jof/patternflood/hardware/laser/MANIFEST.md

# Laser-cut parts

Generated by `hardware/cad/tools/export_dxf.py` from the Onshape enclosure studio —
do not edit by hand; change the model and re-run.

- **40 parts, 28 files.** DXF R12, millimetres, one closed cut path per
  outline/hole on layer `CUT`. Every part is a through-cut of one sheet.
- Cut with **#thickness = 3.18 mm** and **#kerf = 0.15 mm** baked in: tabs and
  holes are already compensated. Both come from the test cuts; re-measure for new stock,
  set them, then re-run this export.
- **Drawn as seen from outside the box.** Cut each part as drawn and the face that
  was up on the bed is its outside face — the bezel's front, the walls' outer faces.
- **To cut the whole box, use [`sheets/`](sheets/README.md)**: every part nested on
  12 × 24" sheets (`nest_sheets.py`).
- **Paper light diffusers** for the knob LEDs: [`diffusers/`](diffusers/README.md) (`diffusers.py`).
- **Cut [`test-cuts/`](test-cuts/README.md) first** — kerf, nut pockets, hole sizes, the
  panel jig and the board templates, all on one 12 × 12" sheet. Then
  [`test-cuts/part-2/`](test-cuts/part-2/README.md): the laminated knob stack, the Pi 5,
  the buttons, the supply's screws and the etch.
- Material: 3 mm Baltic birch, B/BB (enclosure-lasercut.md §13). Everything fits
  across the xTool P2's 305 mm axis.

| File | Qty | Size (mm) | Parts |
|---|---|---|---|
| `bezel-outer.dxf` | 1 | 293.0 × 373.0 | Bezel outer |
| `bezel-inner.dxf` | 1 | 286.6 × 366.6 | Bezel inner |
| `back-cover.dxf` | 1 | 286.0 × 366.0 | Back cover |
| `back-cover-doubler.dxf` | 1 | 285.6 × 309.6 | Back cover doubler |
| `electronics-tray-front-sheet.dxf` | 1 | 279.3 × 94.0 | Electronics tray, front sheet |
| `electronics-tray-rear-sheet-board-nuts.dxf` | 1 | 279.3 × 94.0 | Electronics tray, rear sheet (board nuts) |
| `panel-brace-middle.dxf` | 2 | 293.0 × 80.2 | Panel brace middle; Panel brace middle, rear sheet |
| `panel-brace-middle-middle-sheet-tray-nuts.dxf` | 1 | 293.0 × 80.2 | Panel brace middle, middle sheet (tray nuts) |
| `wall-left.dxf` | 1 | 60.7 × 373.0 | Wall left |
| `wall-right-iec.dxf` | 1 | 60.7 × 373.0 | Wall right (IEC) |
| `wall-bottom.dxf` | 1 | 293.0 × 60.7 | Wall bottom |
| `wall-top.dxf` | 1 | 293.0 × 60.7 | Wall top |
| `wall-left-doubler.dxf` | 1 | 41.1 × 365.6 | Wall left doubler |
| `wall-right-doubler-iec.dxf` | 1 | 41.1 × 365.6 | Wall right doubler (IEC) |
| `stiffener-shelf.dxf` | 1 | 293.0 × 44.8 | Stiffener shelf |
| `panel-brace-upper.dxf` | 1 | 293.0 × 40.2 | Panel brace upper |
| `panel-brace-lower.dxf` | 1 | 293.0 × 40.2 | Panel brace lower |
| `wall-bottom-doubler-psu.dxf` | 1 | 279.3 × 41.1 | Wall bottom doubler (PSU) |
| `wall-top-doubler.dxf` | 1 | 279.3 × 41.1 | Wall top doubler |
| `rail-c-tenoned.dxf` | 2 | 293.0 × 18.2 | Rail C lower (tenoned); Rail C upper (tenoned) |
| `rail-a-screw-clearance.dxf` | 2 | 286.6 × 18.0 | Rail A lower (screw clearance); Rail A upper (screw clearance) |
| `rail-b-lower-hex-pocket.dxf` | 1 | 286.6 × 18.0 | Rail B lower (hex pocket) |
| `rail-b-upper-hex-pocket.dxf` | 1 | 286.6 × 18.0 | Rail B upper (hex pocket) |
| `knob-rib-1.dxf` | 1 | 44.0 × 85.7 | Knob rib 1 |
| `knob-rib-2.dxf` | 1 | 44.0 × 85.7 | Knob rib 2 |
| `spacer-ring-tray-to-brace.dxf` | 4 | 8.0 × 8.0 | Spacer ring — tray to brace |
| `spacer-ring-colorlight.dxf` | 4 | 7.0 × 7.0 | Spacer ring — Colorlight 1; Spacer ring — Colorlight 2; Spacer ring — Colorlight 3; Spacer ring — Colorlight 4 |
| `spacer-ring-pi-m2.5.dxf` | 4 | 7.0 × 7.0 | Spacer ring — Pi 1; Spacer ring — Pi 2; Spacer ring — Pi 3; Spacer ring — Pi 4 |

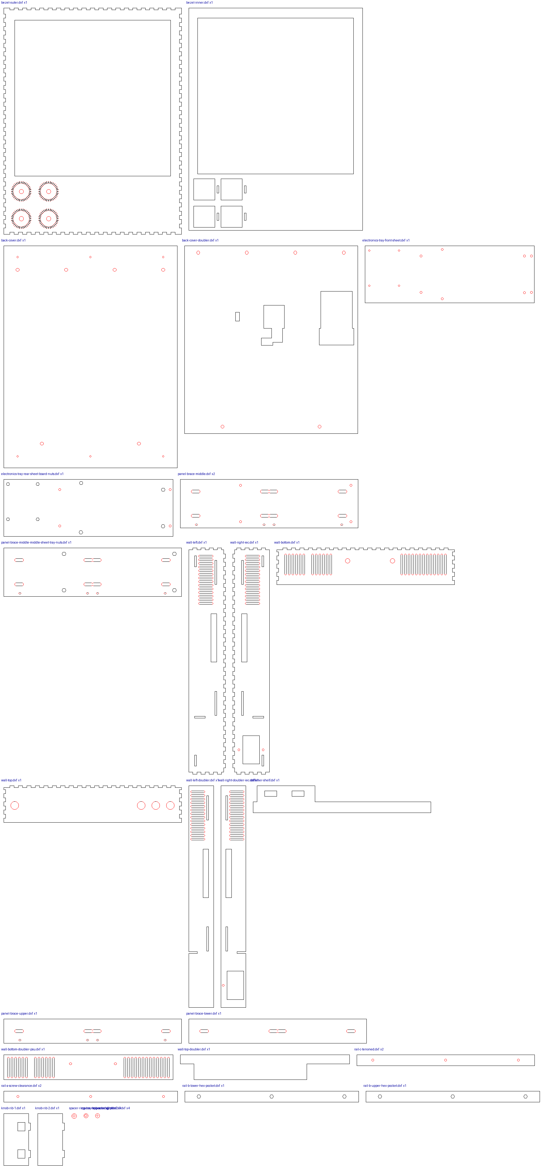
[picture p20: hardware/laser/preview.png]
All parts
