jof/patternflood/docs/desktop/img/box-p2.5.png

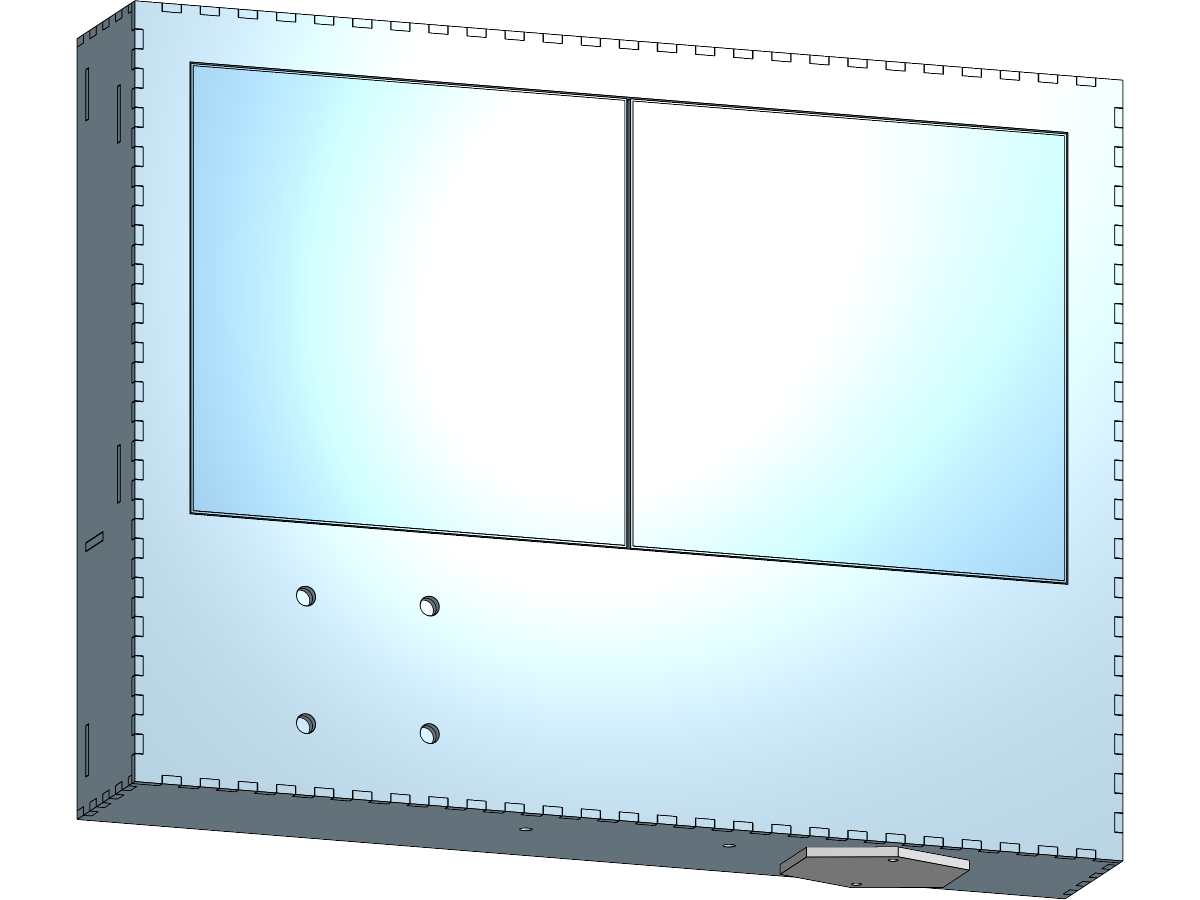
docs/desktop/img/box-p2.5.png
