jof/patternflood/docs/desktop/img/box-p2.png

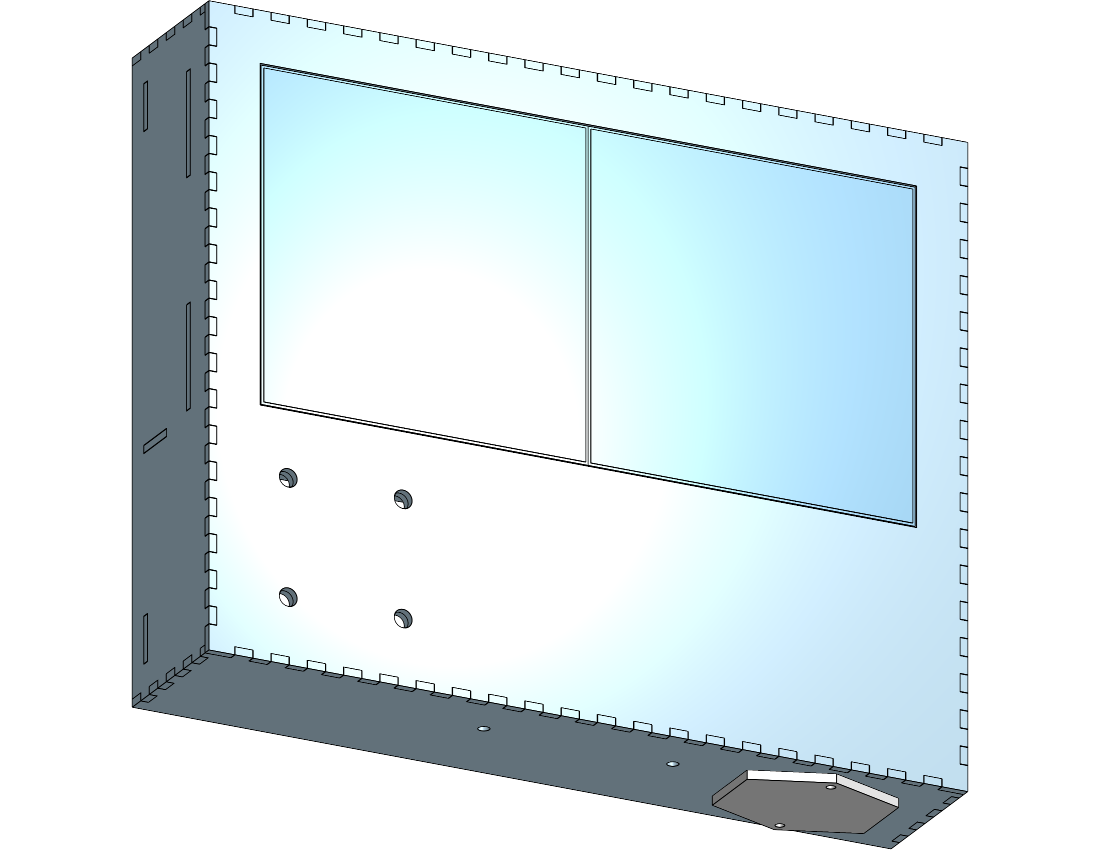
docs/desktop/img/box-p2.png
