jof/patternflood/docs/desktop/img/p2-dims-sheet.png

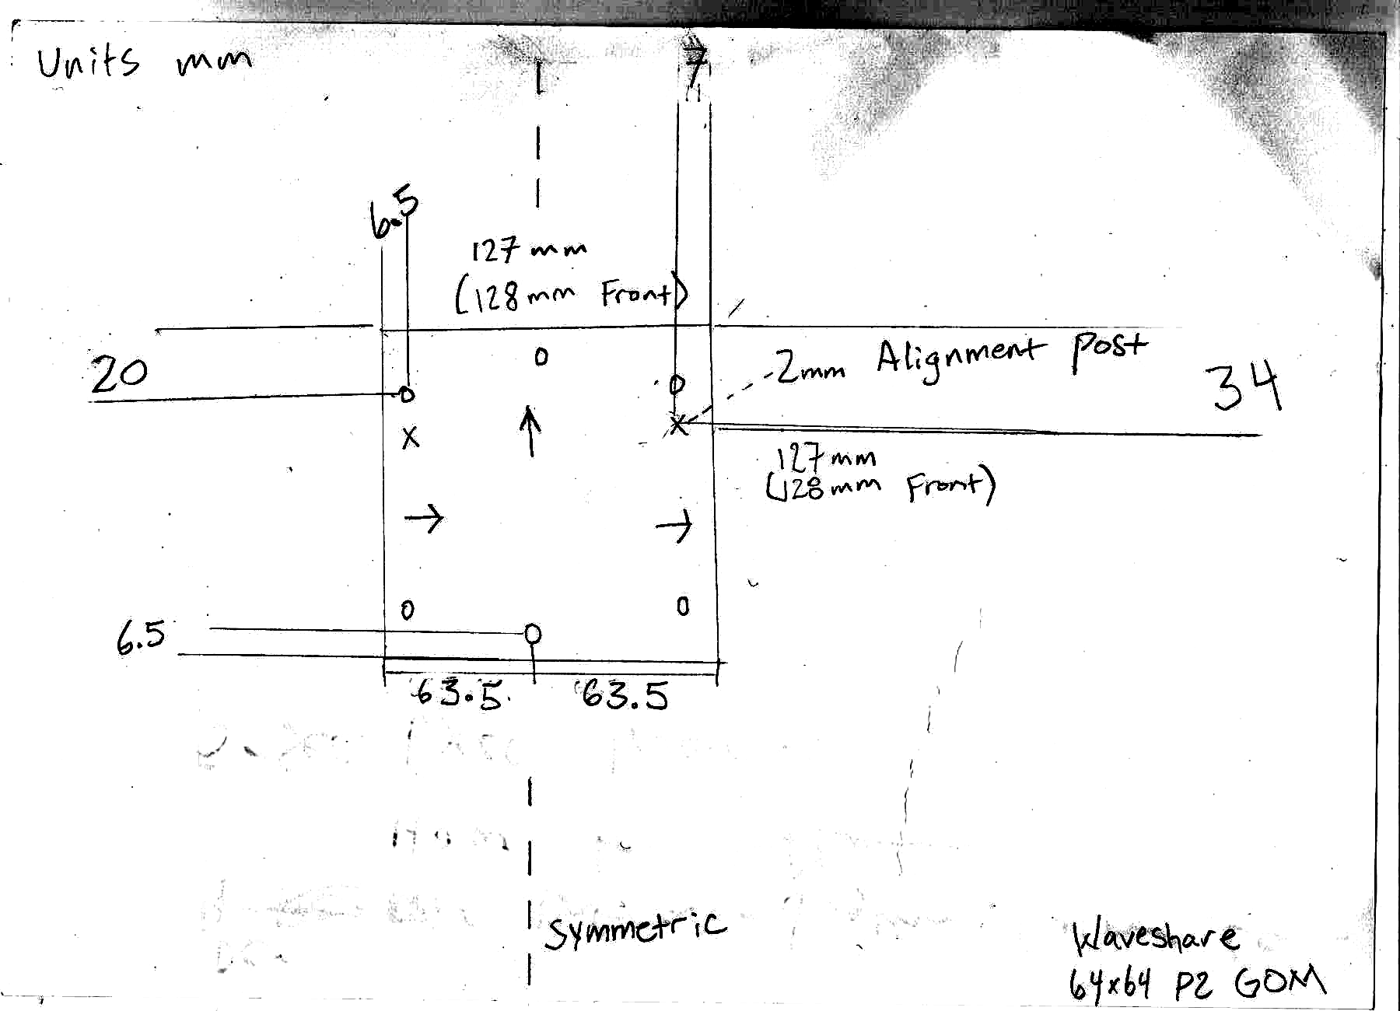
docs/desktop/img/p2-dims-sheet.png
