jof/patternflood/docs/desktop/img/p2-rear-scan-600dpi.jpg

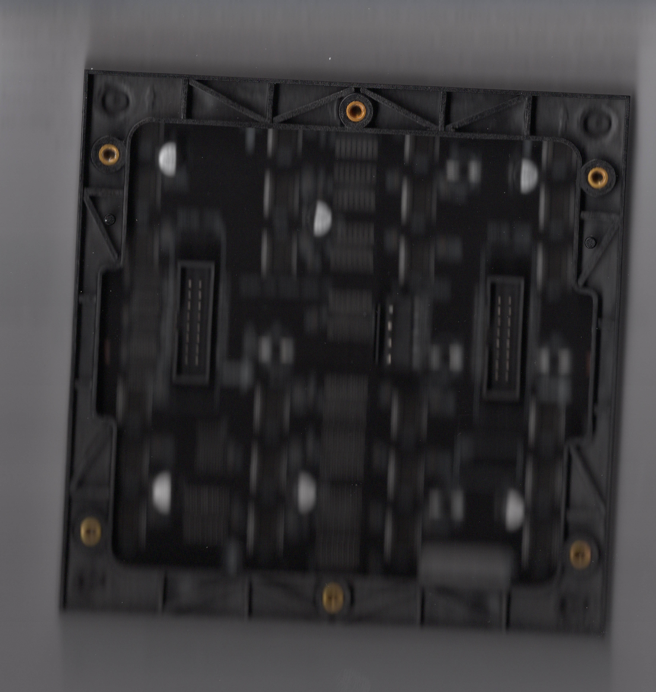
docs/desktop/img/p2-rear-scan-600dpi.jpg
