jof/patternflood/firmware/demos/pfd/demos/earth/day.png

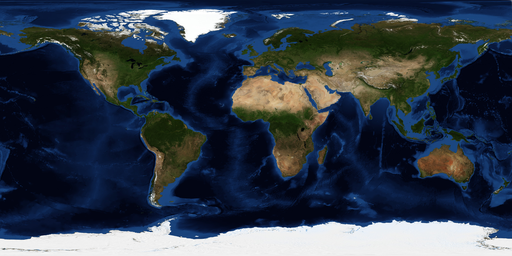
firmware/demos/pfd/demos/earth/day.png
