jof/patternflood/firmware/demos/pfd/demos/earth/night.png

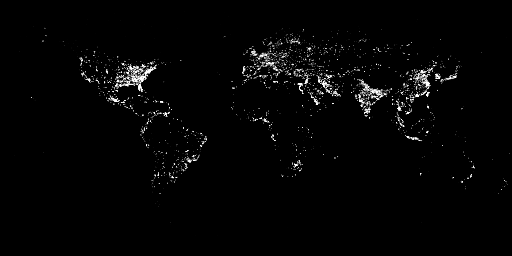
firmware/demos/pfd/demos/earth/night.png
