jof/patternflood/hardware/laser/art/back-cover.decal.png

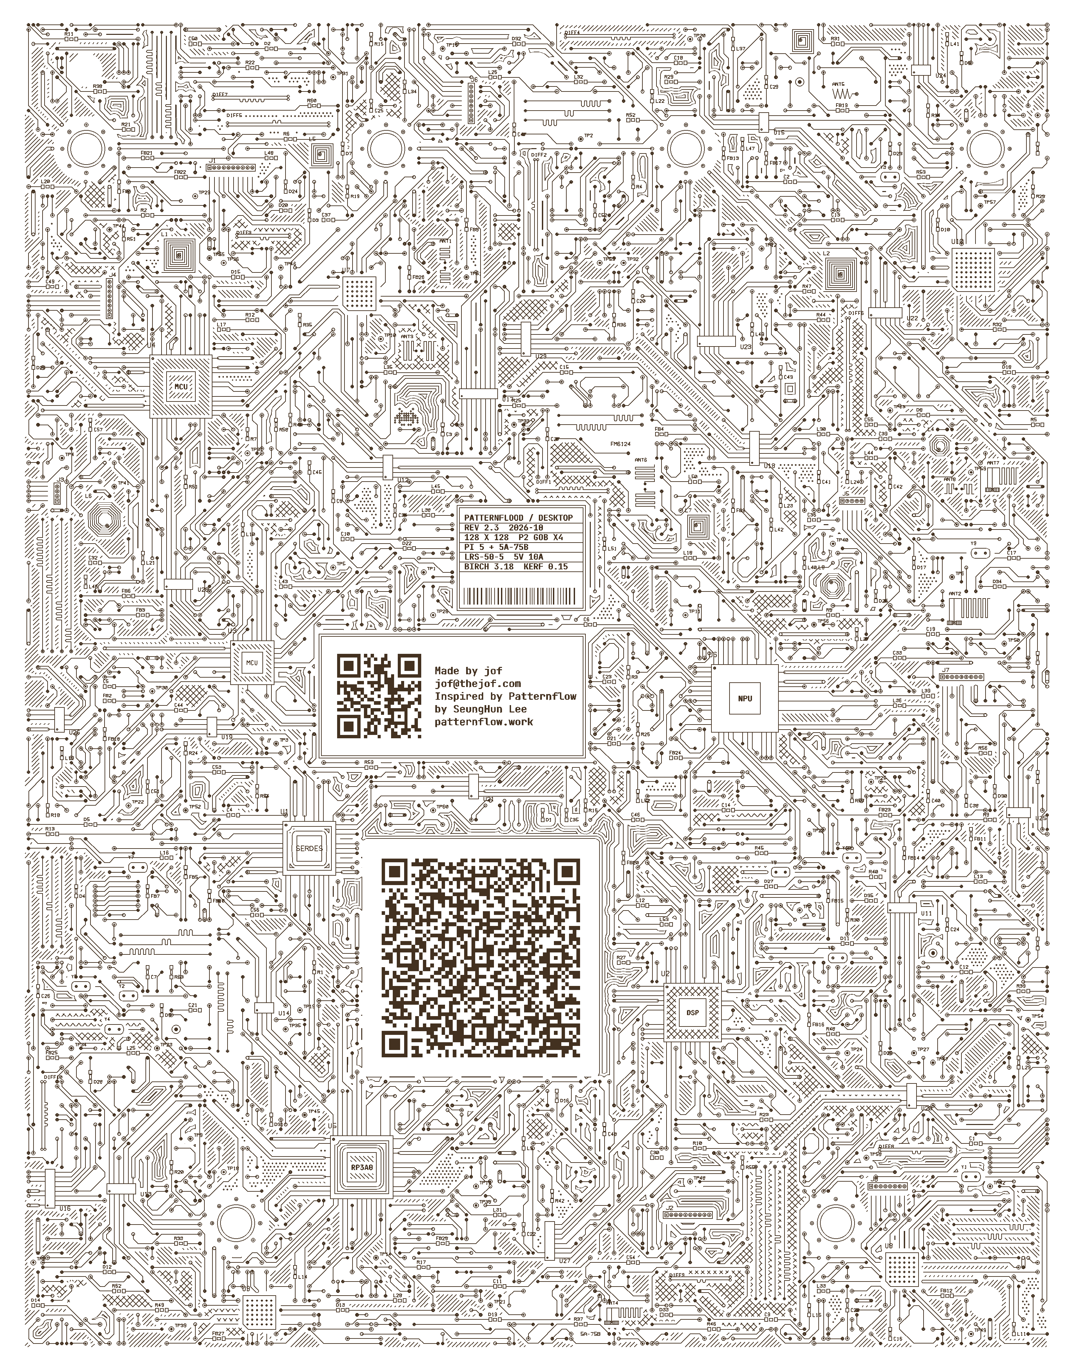
hardware/laser/art/back-cover.decal.png
