jof/patternflood/hardware/laser/art/bezel-outer.decal.png

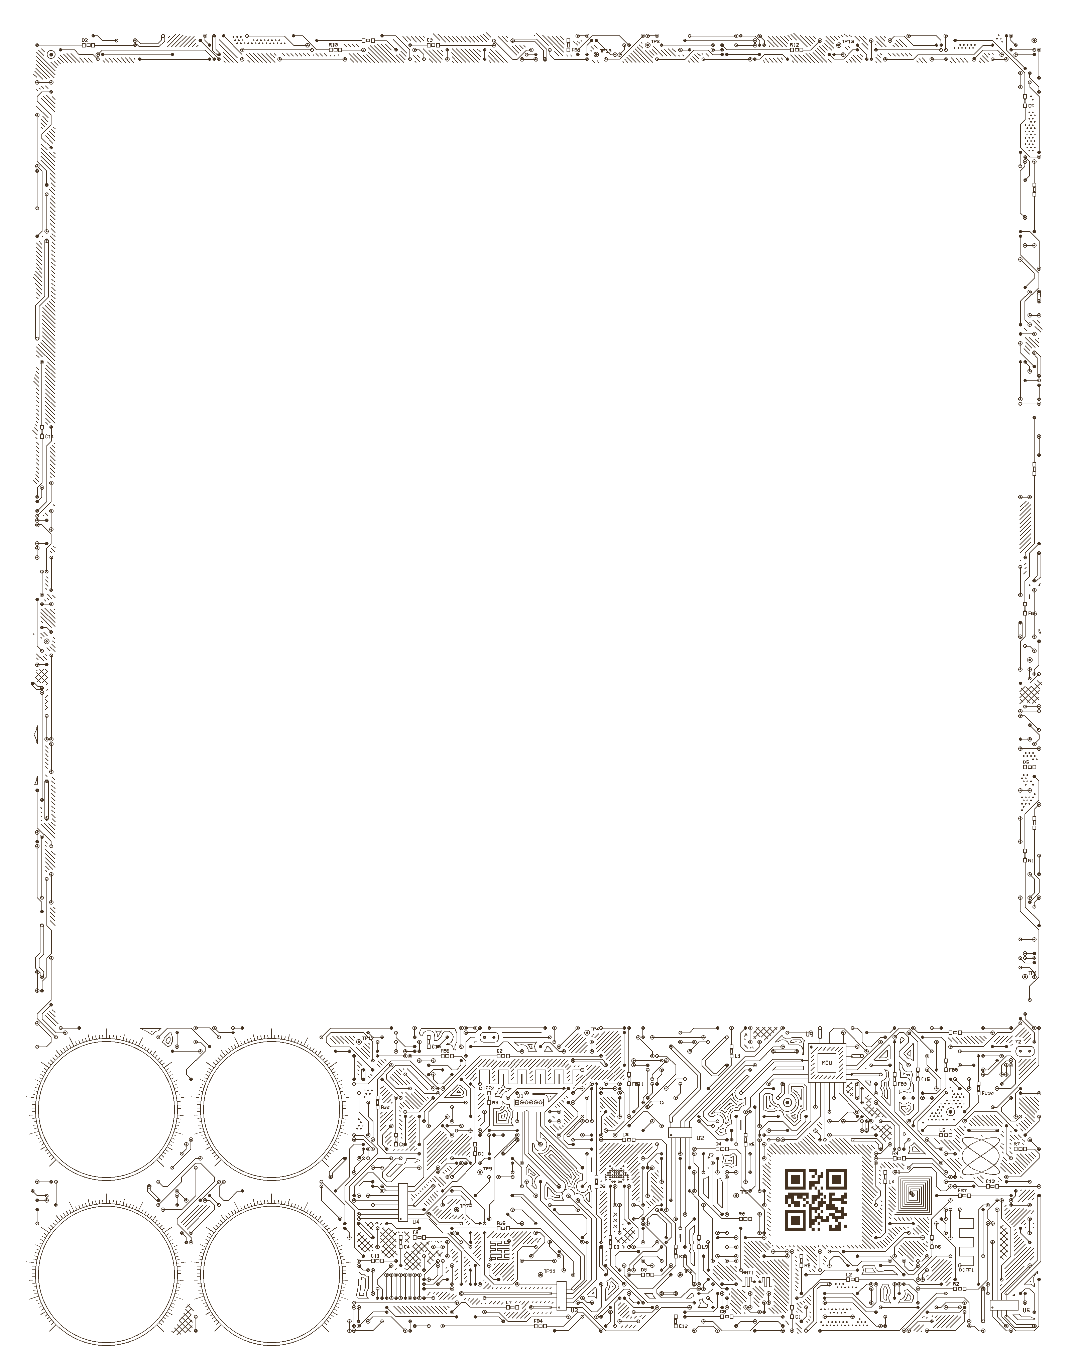
hardware/laser/art/bezel-outer.decal.png
