jof/patternflood/hardware/laser/art/preview.png

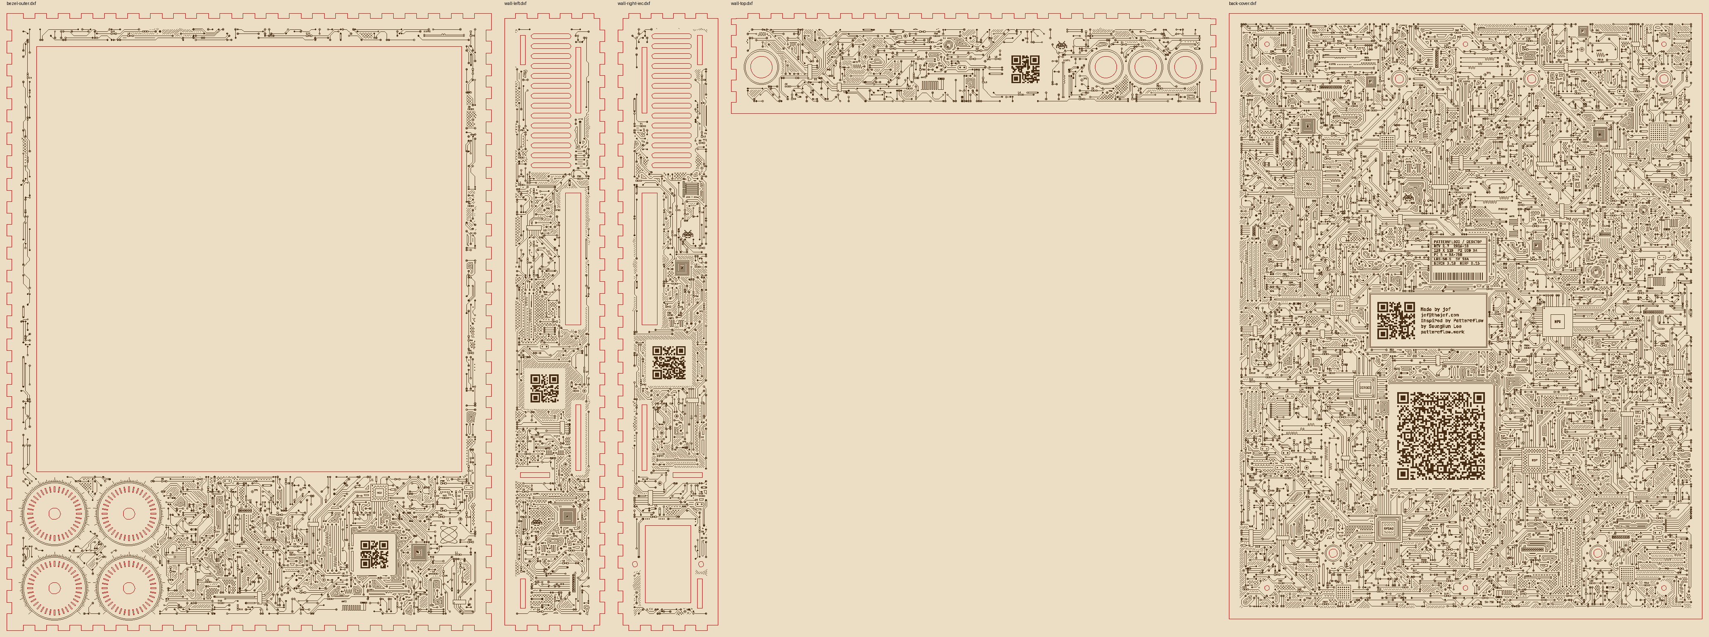
hardware/laser/art/preview.png
