jof/patternflood/hardware/laser/art/wall-left.decal.png

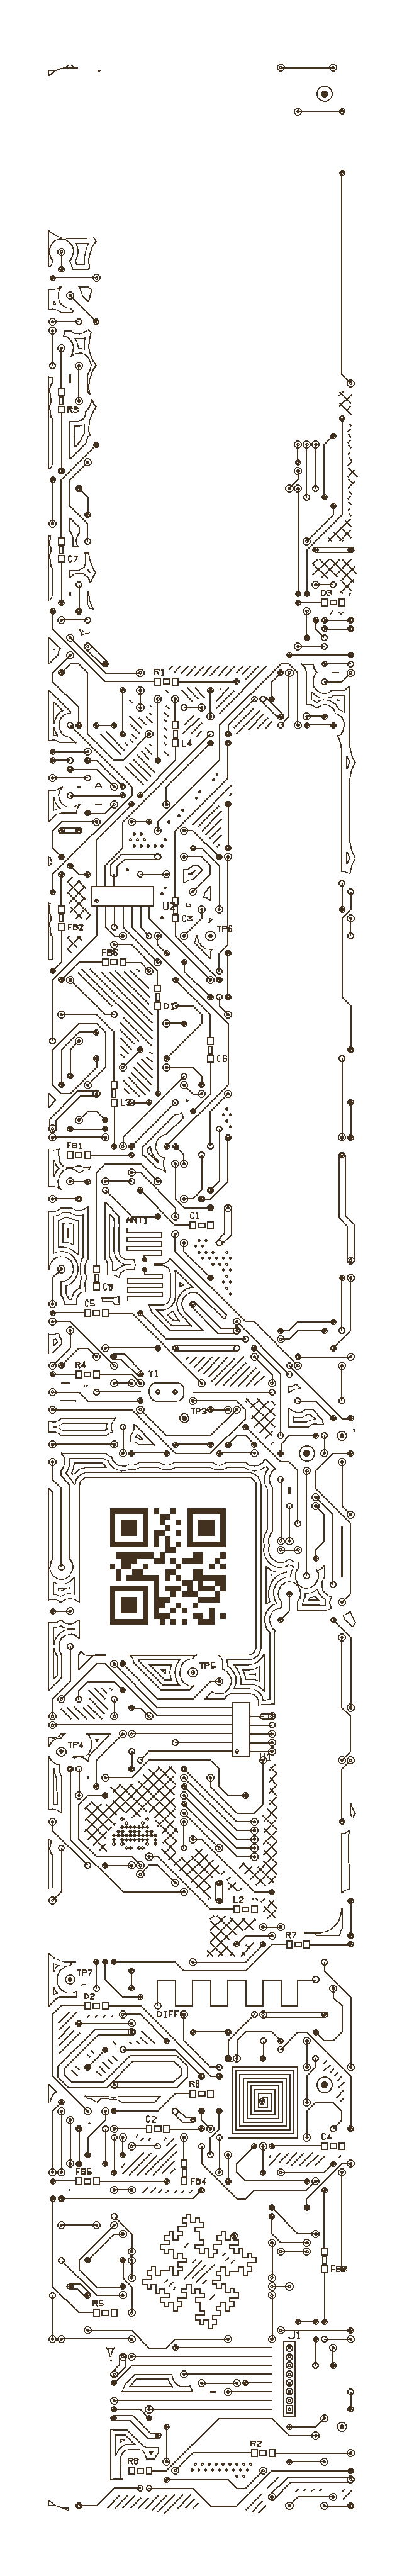
hardware/laser/art/wall-left.decal.png
