jof/patternflood/hardware/laser/art/wall-right-iec.decal.png

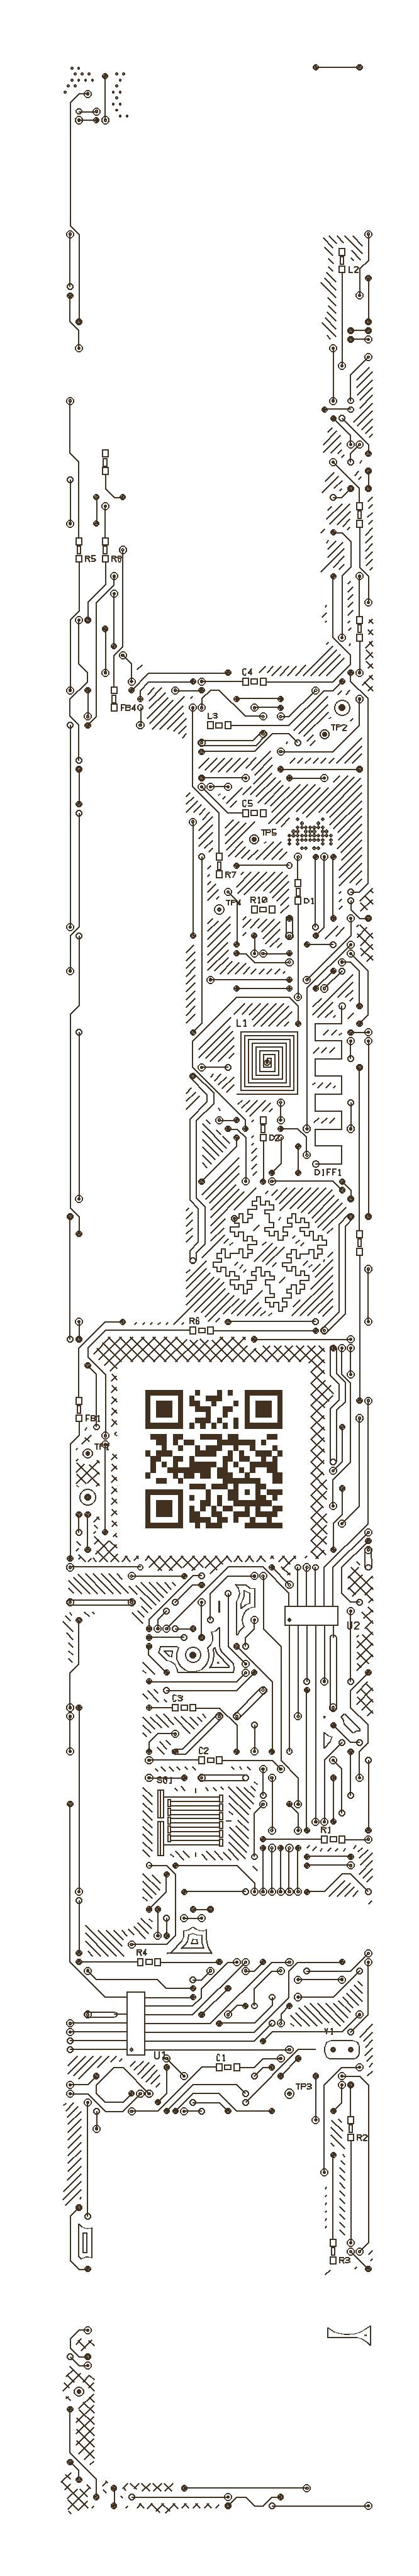
hardware/laser/art/wall-right-iec.decal.png
