jof/patternflood/hardware/laser/art/wall-top.decal.png

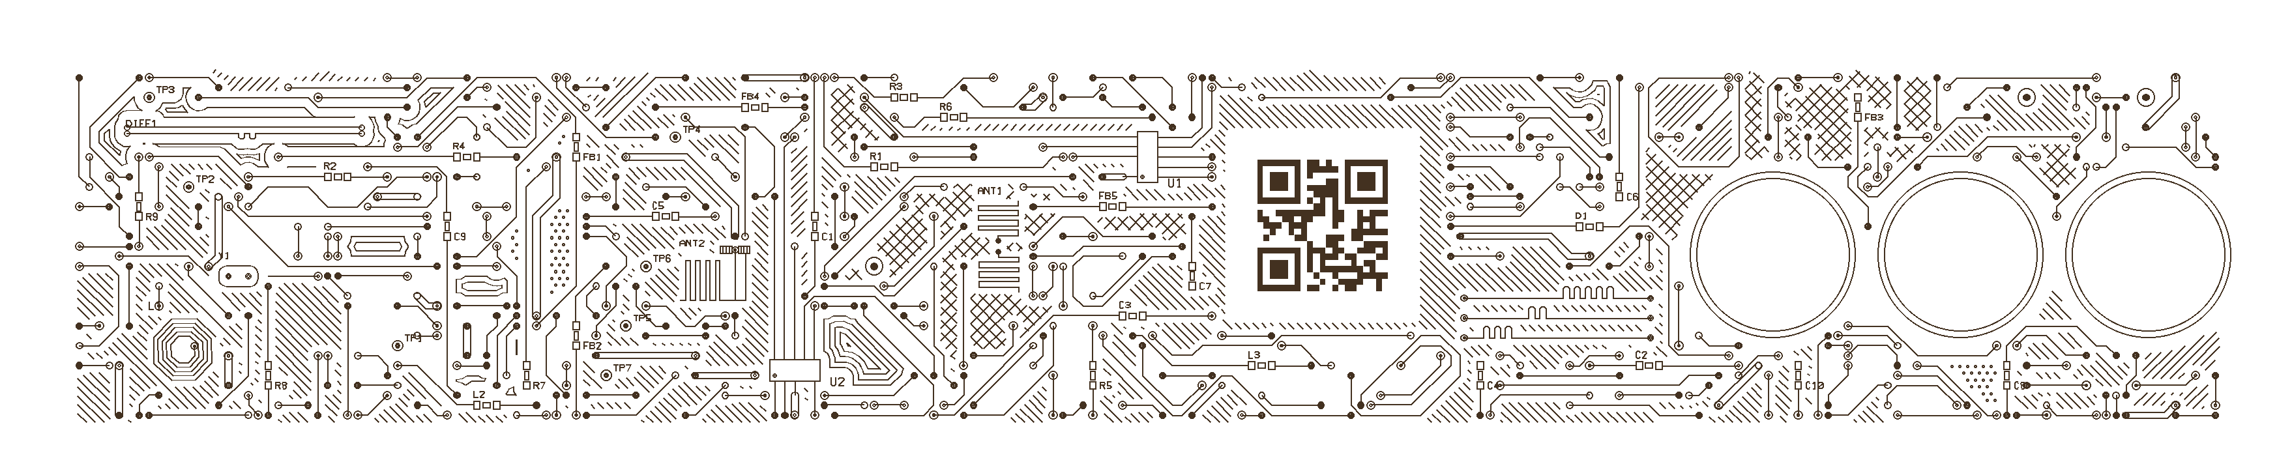
hardware/laser/art/wall-top.decal.png
