jof/patternflood/hardware/laser/sheets/recut-walls.png

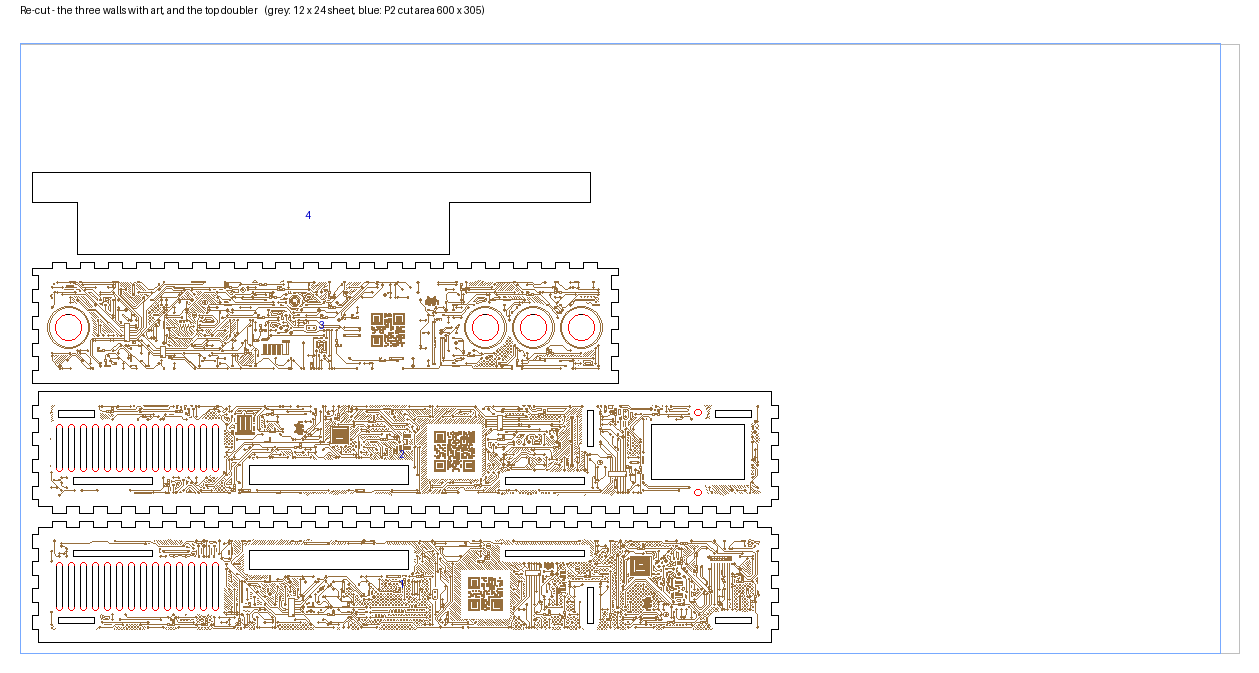
hardware/laser/sheets/recut-walls.png
