jof/patternflood/hardware/laser/art/back-cover.etch.dxf

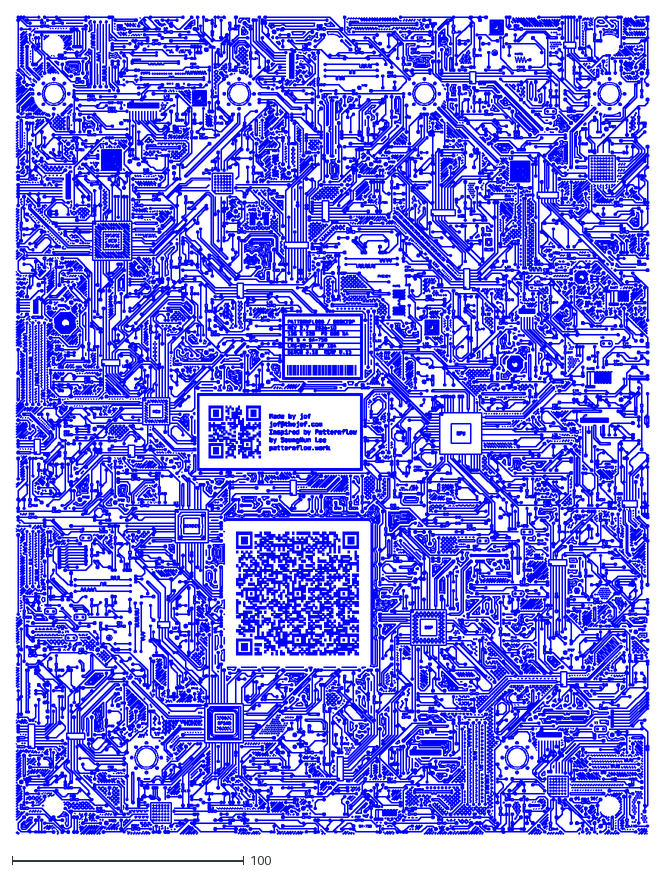
[picture p45: CAD file, 2026-10-26]
hardware/laser/art/back-cover.etch.dxf
273.2 x 353.2
