jof/patternflood/hardware/laser/diffusers/knob-diffusers.dxf

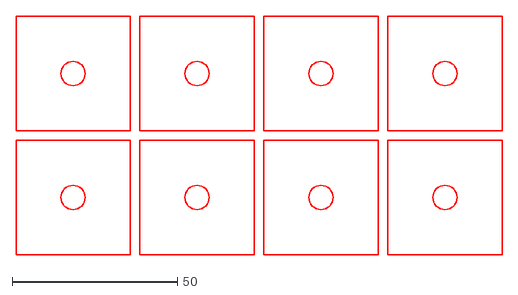
[picture p46: CAD file, 2026-10-25]
hardware/laser/diffusers/knob-diffusers.dxf
147.0 x 72.0
