jof/patternflood/hardware/laser/sheets/recut-walls.dxf

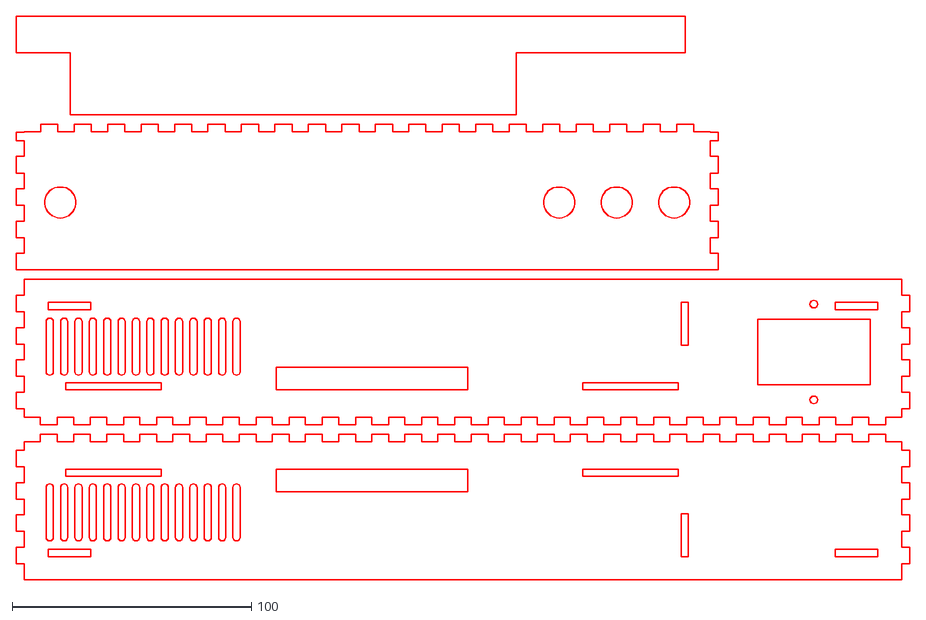
[picture p47: CAD file, 2026-10-26]
hardware/laser/sheets/recut-walls.dxf
373.0 x 235.3
