jof/patternflood/hardware/laser/test-cuts/all-test-cuts.dxf

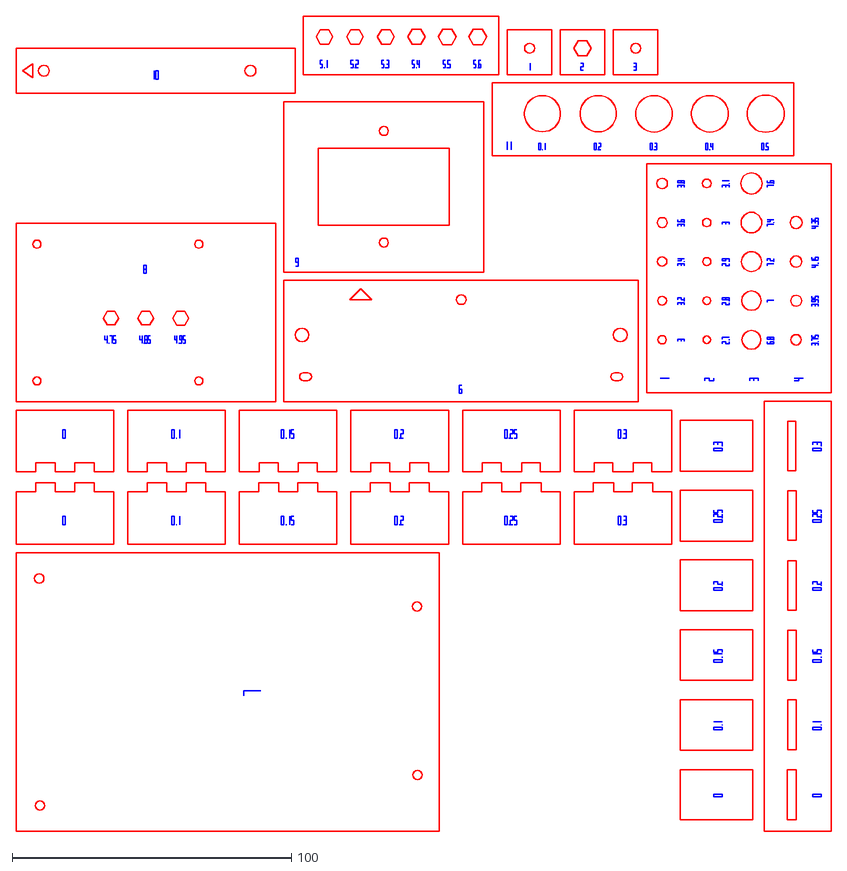
[picture p48: CAD file, 2026-10-26]
hardware/laser/test-cuts/all-test-cuts.dxf
292.0 x 292.0
