jof/patternflood/hardware/laser/test-cuts/part-2/17-pi-spacer-rings.dxf

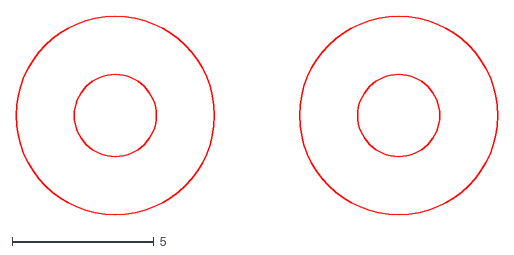
[picture p49: CAD file, 2026-10-30]
hardware/laser/test-cuts/part-2/17-pi-spacer-rings.dxf
17.0 x 7.00
