jof/patternflood/hardware/laser/test-cuts/since-rev-1/all-since-rev-1.dxf

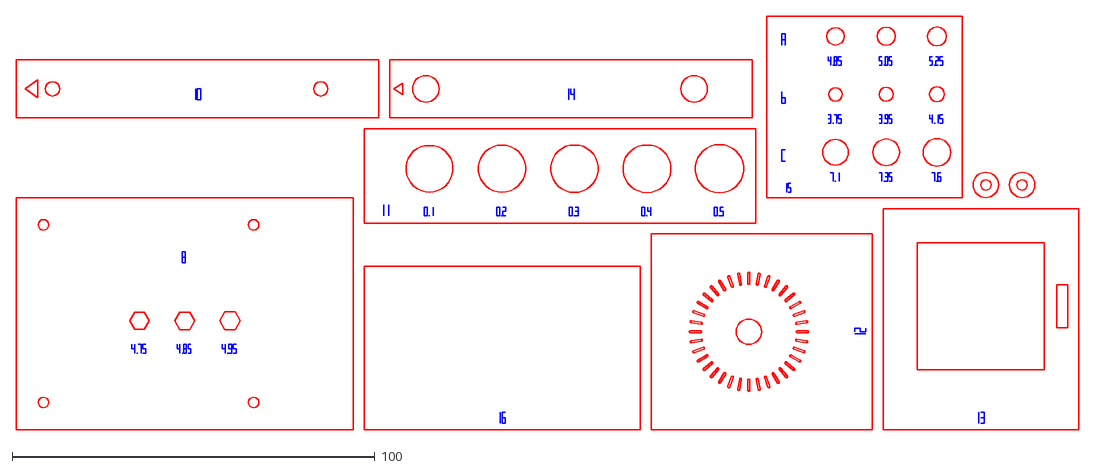
[picture p50: CAD file, 2026-10-26]
hardware/laser/test-cuts/since-rev-1/all-since-rev-1.dxf
293.1 x 114.0
