jof/patternflood/hardware/laser/wall-top.dxf

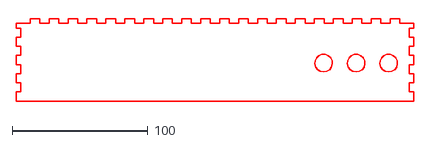
[picture p51: CAD file, 2026-10-26]
hardware/laser/wall-top.dxf
293.0 x 60.7
