jof/patternflood/hardware/laser/art/wall-top.etch.dxf

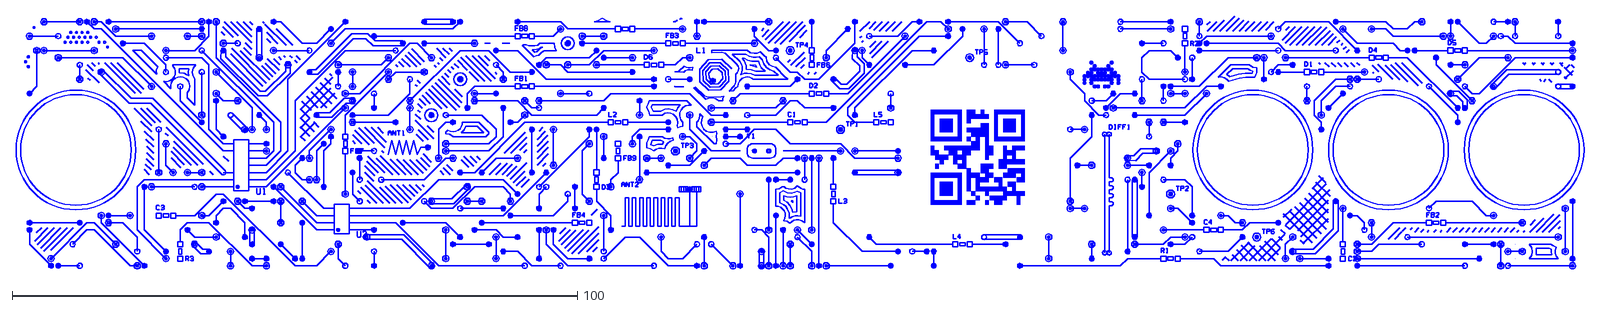
[picture p52: CAD file, 2026-10-26]
hardware/laser/art/wall-top.etch.dxf
277.5 x 44.7
