jof/patternflood/hardware/laser/diffusers/knob-diffuser.dxf

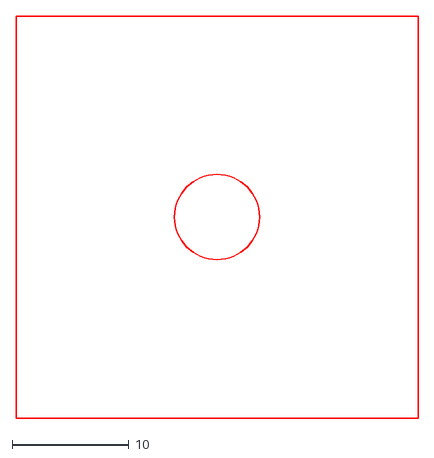
[picture p53: CAD file, 2026-10-25]
hardware/laser/diffusers/knob-diffuser.dxf
34.5 x 34.5
