jof/patternflood/hardware/laser/sheets/sheet-4.dxf

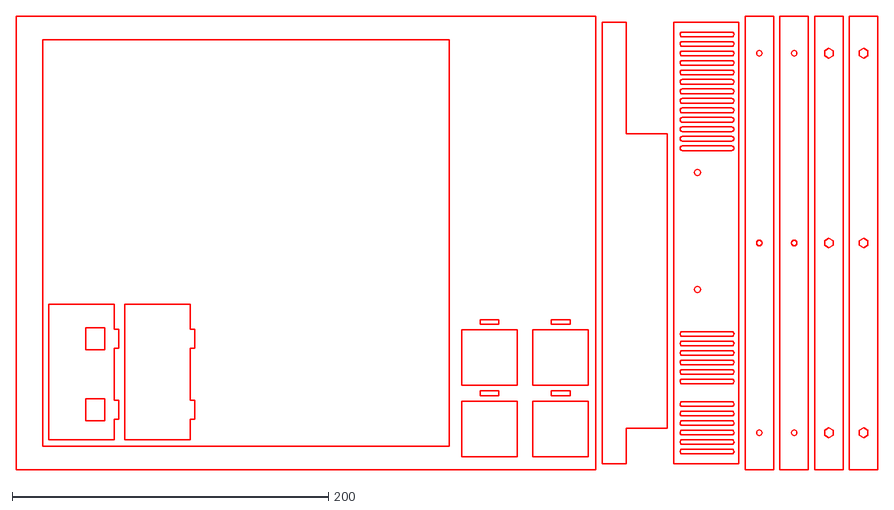
[picture p54: CAD file, 2026-10-26]
hardware/laser/sheets/sheet-4.dxf
544.9 x 286.6
