jof/patternflood/hardware/laser/test-cuts/05-hole-gauge.dxf

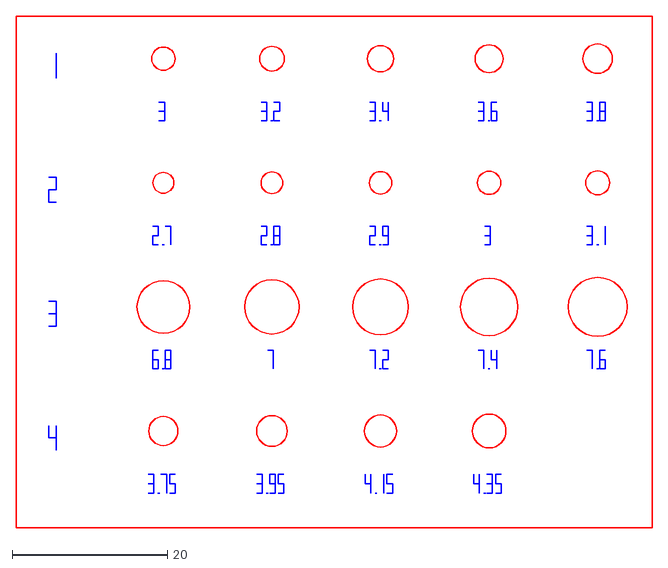
[picture p55: CAD file, 2026-10-25]
hardware/laser/test-cuts/05-hole-gauge.dxf
82.0 x 66.0
