jof/patternflood/hardware/laser/test-cuts/part-2/14-psu-head-recesses.dxf

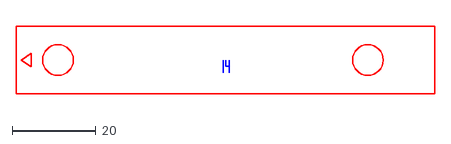
[picture p56: CAD file, 2026-10-30]
hardware/laser/test-cuts/part-2/14-psu-head-recesses.dxf
100.0 x 16.0
