jof/patternflood/hardware/laser/test-cuts/since-rev-1/10-psu-side-holes.dxf

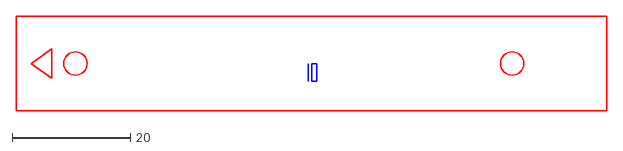
[picture p57: CAD file, 2026-10-25]
hardware/laser/test-cuts/since-rev-1/10-psu-side-holes.dxf
100.0 x 16.0
