jof/patternflood/hardware/laser/wall-bottom.dxf

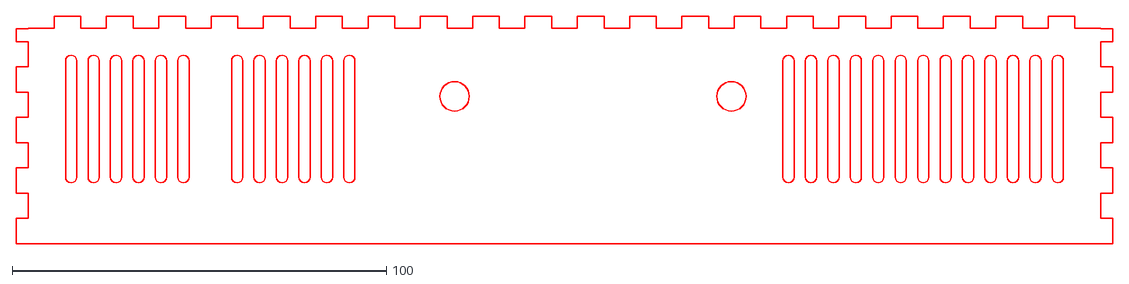
[picture p58: CAD file, 2026-10-25]
hardware/laser/wall-bottom.dxf
293.0 x 60.7
