jof/patternflood/hardware/laser/art/wall-left.etch.dxf

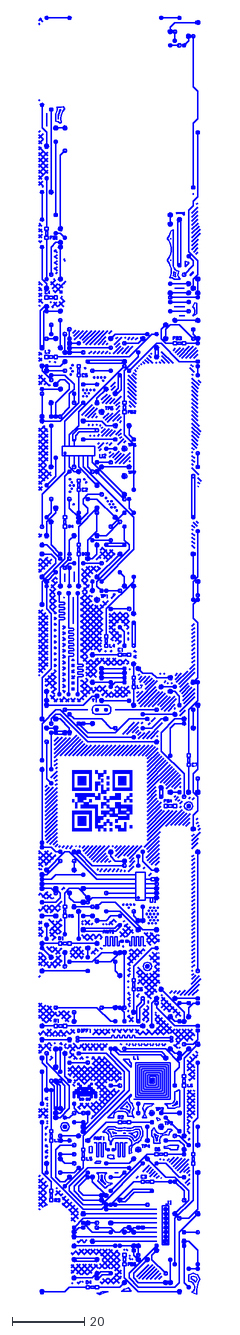
[picture p59: CAD file, 2026-10-26]
hardware/laser/art/wall-left.etch.dxf
45.0 x 354.3
