jof/patternflood/hardware/laser/back-cover-doubler.dxf

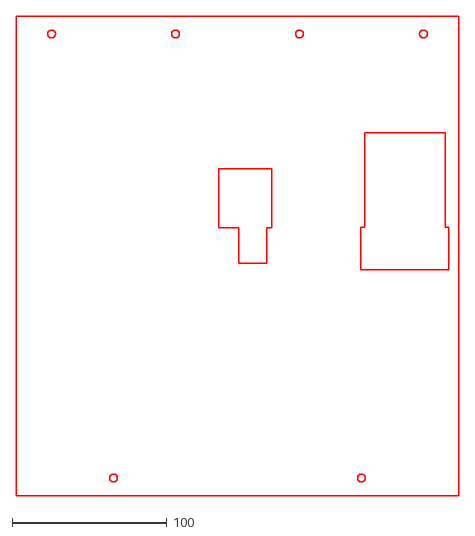
[picture p60: CAD file, 2026-10-25]
hardware/laser/back-cover-doubler.dxf
285.6 x 309.6
