jof/patternflood/hardware/laser/sheets/sheet-3.dxf

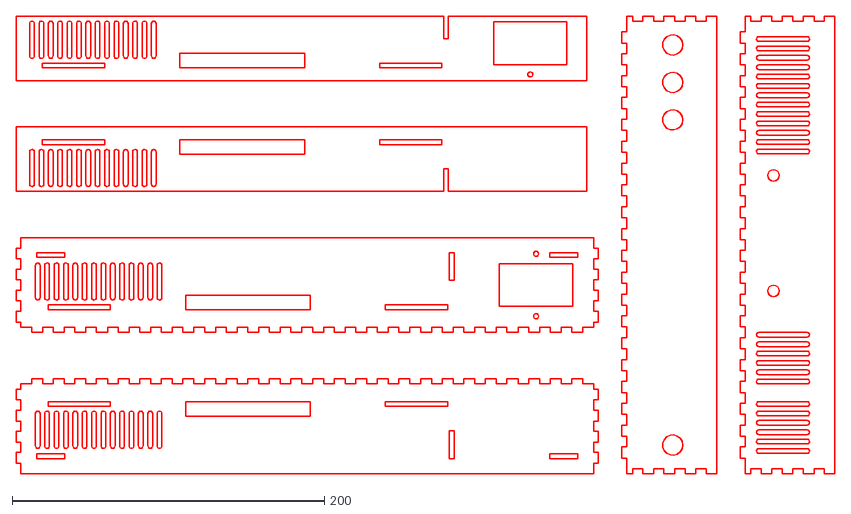
[picture p61: CAD file, 2026-10-26]
hardware/laser/sheets/sheet-3.dxf
524.4 x 293.0
