jof/patternflood/hardware/laser/test-cuts/11-push-button-keys.dxf

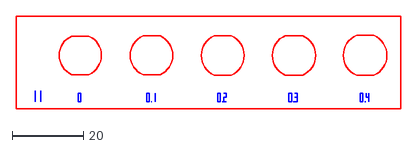
[picture p62: CAD file, 2026-10-25]
hardware/laser/test-cuts/11-push-button-keys.dxf
108.0 x 26.0
