jof/patternflood/hardware/laser/test-cuts/part-2/15-new-holes-gauge.dxf

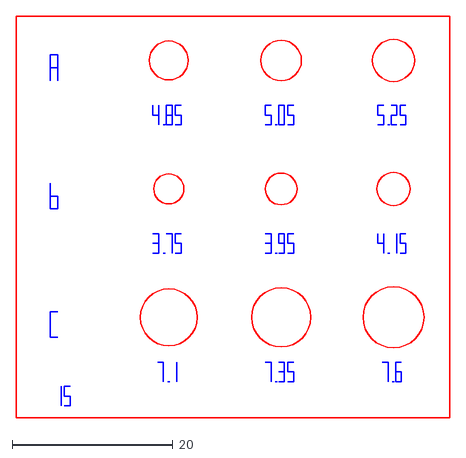
[picture p63: CAD file, 2026-10-30]
hardware/laser/test-cuts/part-2/15-new-holes-gauge.dxf
54.0 x 50.0
