jof/patternflood/hardware/laser/test-cuts/since-rev-1/08-pi-5-template.dxf

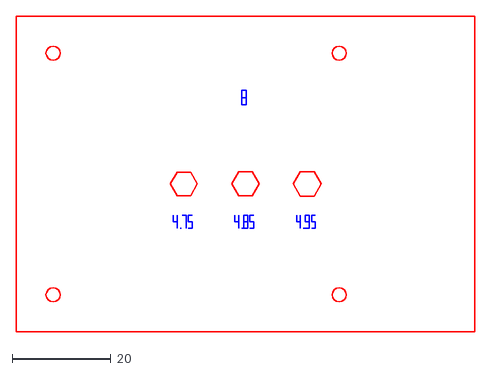
[picture p64: CAD file, 2026-10-25]
hardware/laser/test-cuts/since-rev-1/08-pi-5-template.dxf
93.0 x 64.0
