jof/patternflood/hardware/laser/art/wall-right-iec.etch.dxf

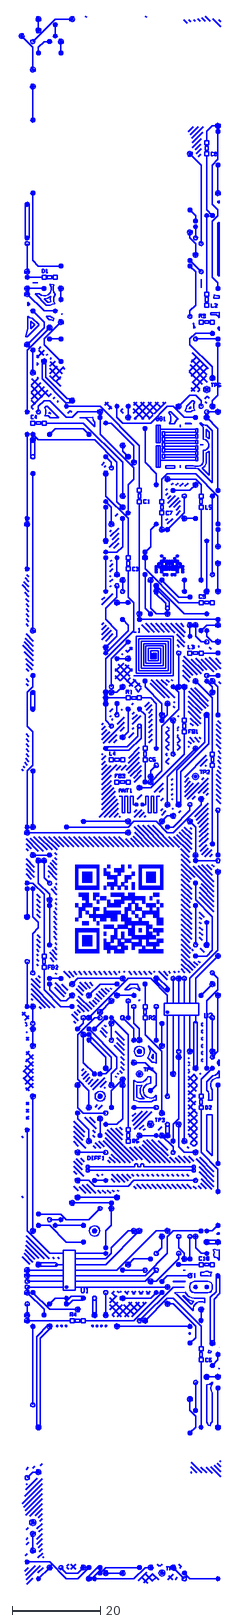
[picture p65: CAD file, 2026-10-26]
hardware/laser/art/wall-right-iec.etch.dxf
45.7 x 355.0
