jof/patternflood/hardware/laser/sheets/sheet-6.dxf

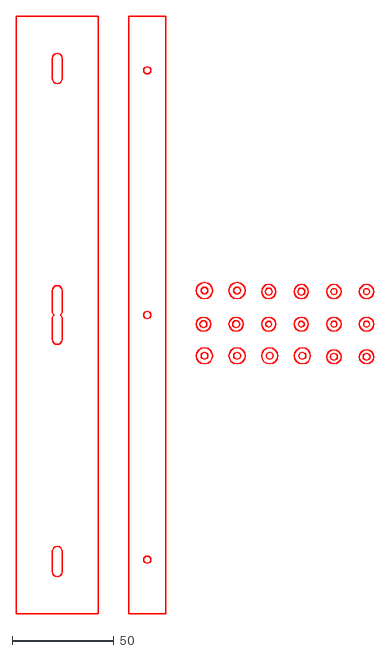
[picture p66: CAD file, 2026-10-26]
hardware/laser/sheets/sheet-6.dxf
175.3 x 293.0
