jof/patternflood/hardware/laser/test-cuts/06-panel-fit-jig.dxf

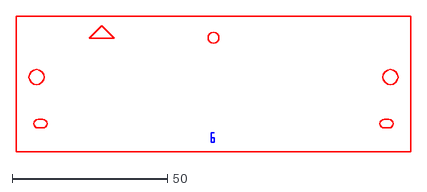
[picture p67: CAD file, 2026-10-18]
hardware/laser/test-cuts/06-panel-fit-jig.dxf
127.0 x 43.5
