jof/patternflood/hardware/laser/test-cuts/part-2/13-knob-inner-sheet.dxf

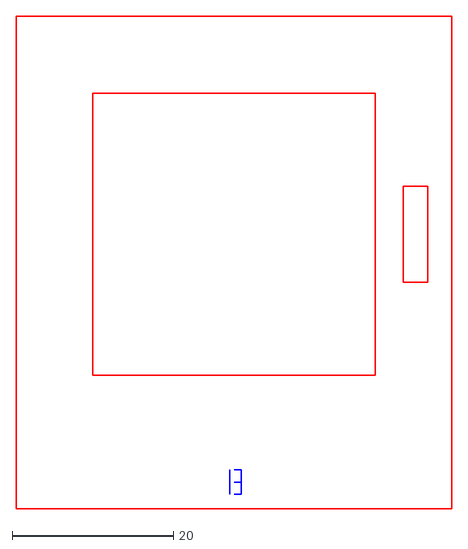
[picture p68: CAD file, 2026-10-30]
hardware/laser/test-cuts/part-2/13-knob-inner-sheet.dxf
54.0 x 61.0
