jof/patternflood/hardware/laser/test-cuts/since-rev-1/16-etch-sampler.dxf

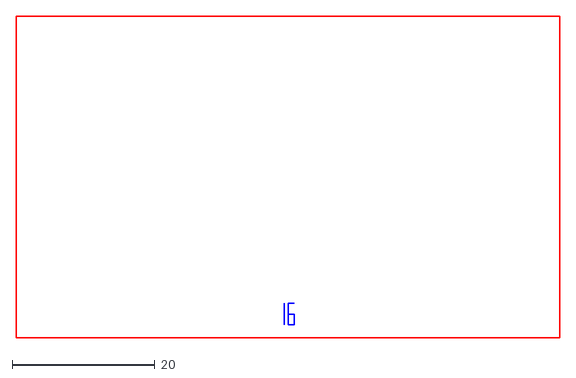
[picture p69: CAD file, 2026-10-25]
hardware/laser/test-cuts/since-rev-1/16-etch-sampler.dxf
76.1 x 45.0
