jof/patternflood/hardware/laser/wall-top-doubler.dxf

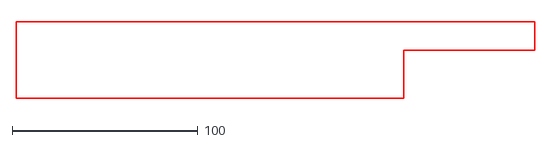
[picture p70: CAD file, 2026-10-25]
hardware/laser/wall-top-doubler.dxf
279.3 x 41.1
