jof/patternflood/hardware/laser/art/bezel-outer.etch.dxf

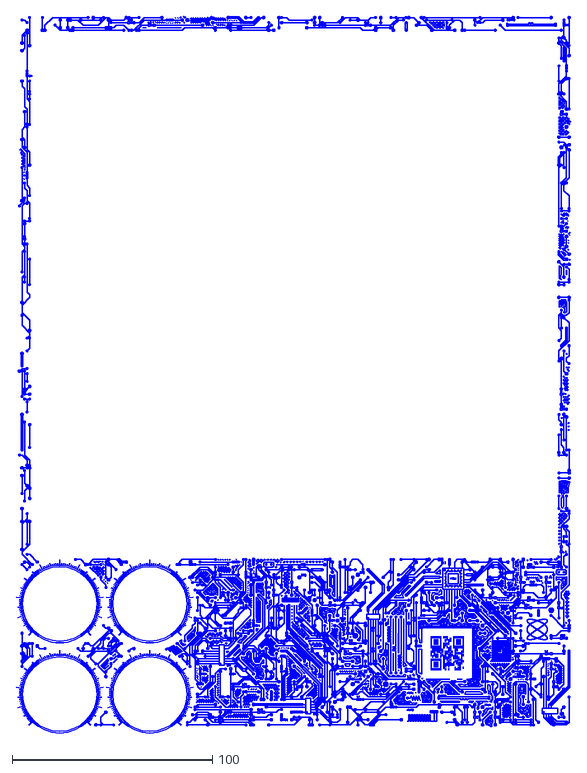
[picture p71: CAD file, 2026-10-26]
hardware/laser/art/bezel-outer.etch.dxf
276.8 x 357.9
