jof/patternflood/hardware/laser/sheets/sheet-1.dxf

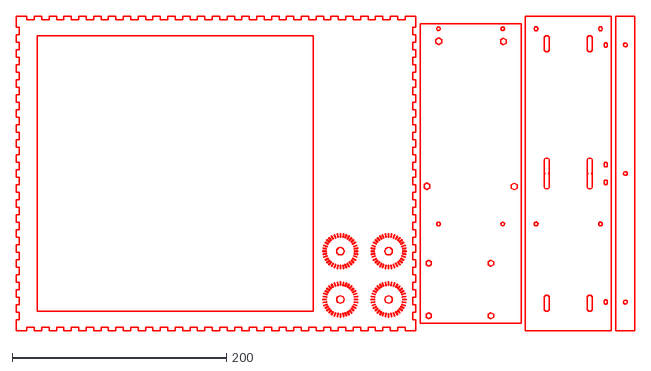
[picture p72: CAD file, 2026-10-26]
hardware/laser/sheets/sheet-1.dxf
577.3 x 293.0
