jof/patternflood/hardware/laser/test-cuts/07-colorlight-template.dxf

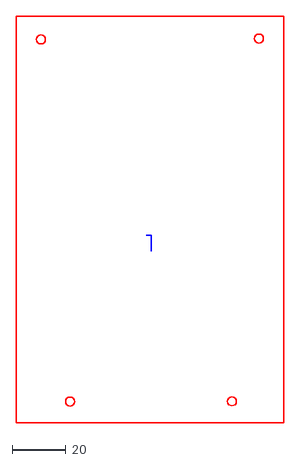
[picture p73: CAD file, 2026-10-18]
hardware/laser/test-cuts/07-colorlight-template.dxf
99.8 x 151.7
