jof/patternflood/hardware/laser/test-cuts/part-2/11-push-button-keys.dxf

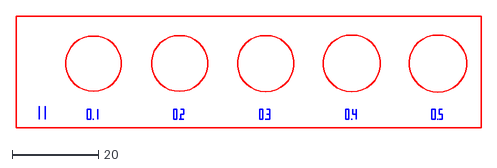
[picture p74: CAD file, 2026-10-30]
hardware/laser/test-cuts/part-2/11-push-button-keys.dxf
108.0 x 26.0
