jof/patternflood/hardware/laser/wall-left-doubler.dxf

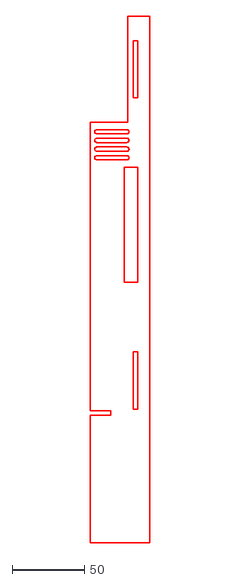
[picture p75: CAD file, 2026-10-25]
hardware/laser/wall-left-doubler.dxf
41.1 x 365.6
