jof/patternflood/hardware/laser/sheets/sheet-5.dxf

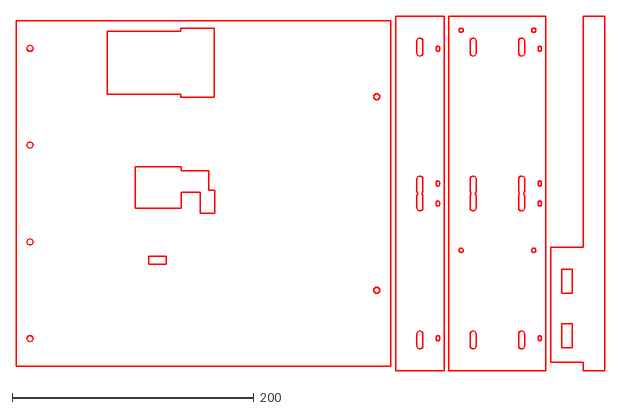
[picture p76: CAD file, 2026-10-26]
hardware/laser/sheets/sheet-5.dxf
486.8 x 293.0
