jof/patternflood/hardware/laser/test-cuts/09-iec-cutout.dxf

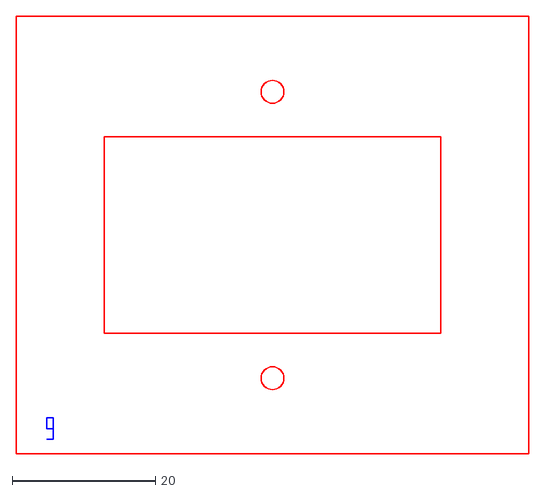
[picture p77: CAD file, 2026-10-18]
hardware/laser/test-cuts/09-iec-cutout.dxf
71.6 x 61.1
