jof/patternflood/hardware/laser/test-cuts/part-2/12-knob-outer-sheet.dxf

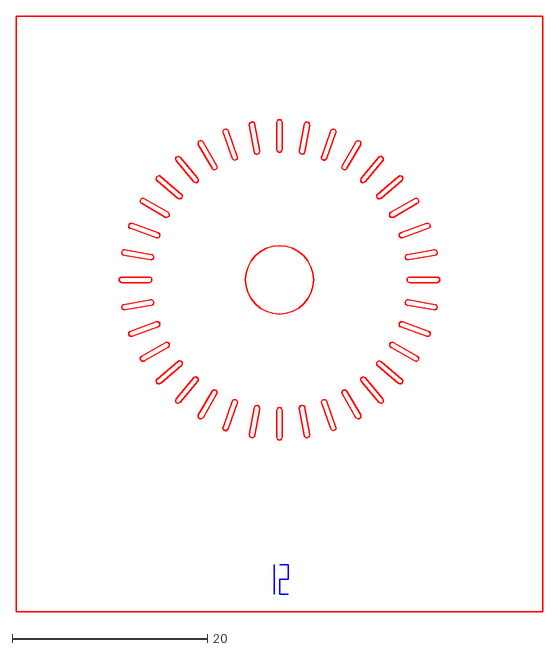
[picture p78: CAD file, 2026-10-30]
hardware/laser/test-cuts/part-2/12-knob-outer-sheet.dxf
54.0 x 61.0
