jof/patternflood/hardware/laser/wall-left.dxf

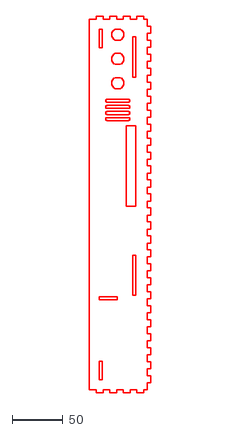
[picture p79: CAD file, 2026-10-25]
hardware/laser/wall-left.dxf
60.7 x 373.0
