jof/patternflood/hardware/laser/bezel-outer.dxf

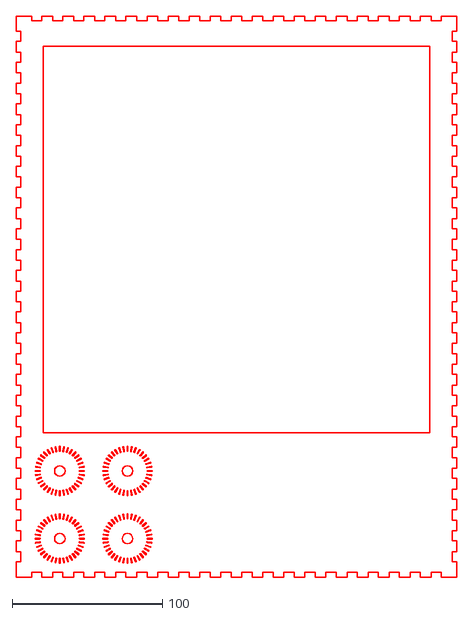
[picture p80: CAD file, 2026-10-22]
hardware/laser/bezel-outer.dxf
293.0 x 373.0
