jof/patternflood/hardware/laser/sheets/sheet-2.dxf

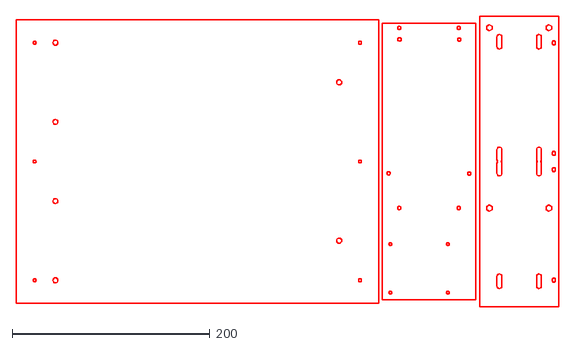
[picture p81: CAD file, 2026-10-26]
hardware/laser/sheets/sheet-2.dxf
548.2 x 293.0
