jof/patternflood/hardware/laser/test-cuts/08-pi-zero-template.dxf

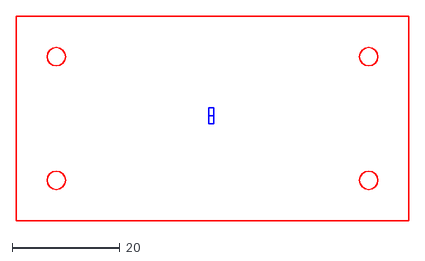
[picture p82: CAD file, 2026-10-18]
hardware/laser/test-cuts/08-pi-zero-template.dxf
73.0 x 38.0
