jof/patternflood/hardware/laser/wall-bottom-doubler-psu.dxf

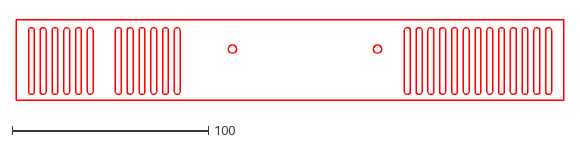
[picture p83: CAD file, 2026-10-21]
hardware/laser/wall-bottom-doubler-psu.dxf
279.3 x 41.1
