jof/patternflood/hardware/laser/back-cover.dxf

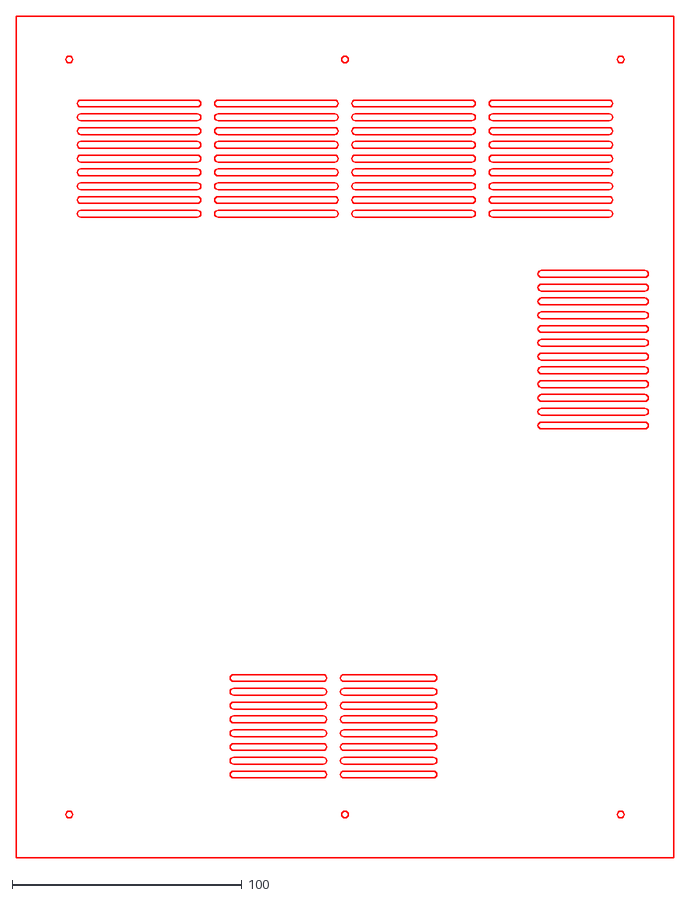
[picture p84: CAD file, 2026-10-21]
hardware/laser/back-cover.dxf
286.0 x 366.0
