jof/patternflood/hardware/laser/test-cuts/10-psu-side-holes.dxf

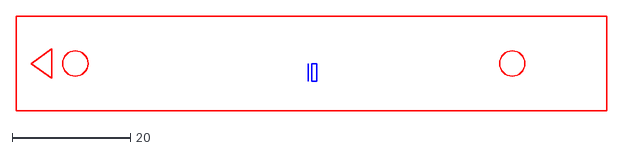
[picture p85: CAD file, 2026-10-18]
hardware/laser/test-cuts/10-psu-side-holes.dxf
100.0 x 16.0
