jof/patternflood/hardware/laser/stiffener-shelf.dxf

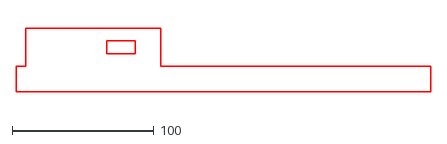
[picture p86: CAD file, 2026-10-21]
hardware/laser/stiffener-shelf.dxf
293.0 x 44.8
