jof/patternflood/hardware/laser/test-cuts/01-kerf-finger-comb.dxf

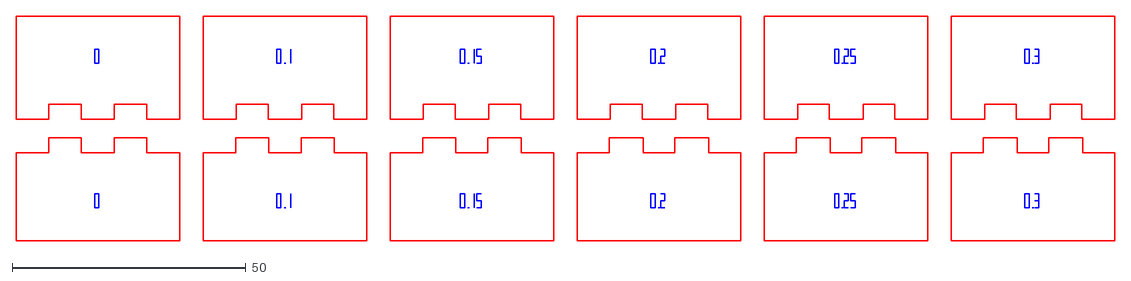
[picture p87: CAD file, 2026-10-18]
hardware/laser/test-cuts/01-kerf-finger-comb.dxf
235.0 x 48.0
