jof/patternflood/hardware/laser/test-cuts/02-kerf-tenon-mortise.dxf

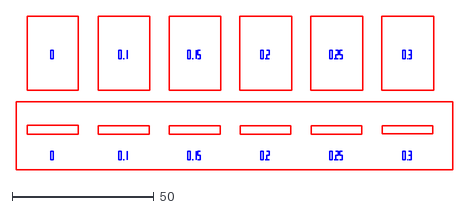
[picture p88: CAD file, 2026-10-18]
hardware/laser/test-cuts/02-kerf-tenon-mortise.dxf
154.0 x 54.0
