jof/patternflood/hardware/laser/wall-right-doubler-iec.dxf

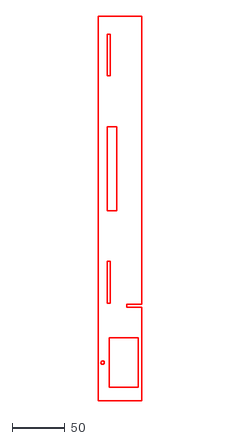
[picture p89: CAD file, 2026-10-21]
hardware/laser/wall-right-doubler-iec.dxf
41.1 x 365.6
