jof/patternflood/hardware/laser/electronics-tray-rear-sheet-board-nuts.dxf

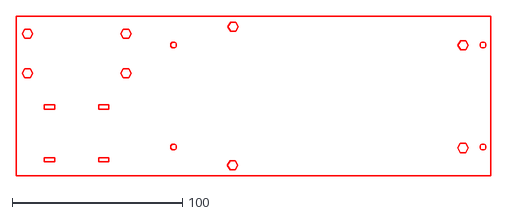
[picture p90: CAD file, 2026-10-21]
hardware/laser/electronics-tray-rear-sheet-board-nuts.dxf
279.3 x 94.0
