jof/patternflood/hardware/laser/electronics-tray-front-sheet.dxf

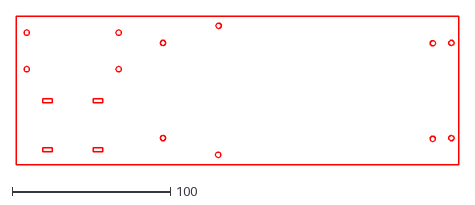
[picture p91: CAD file, 2026-10-21]
hardware/laser/electronics-tray-front-sheet.dxf
279.3 x 94.0
