jof/patternflood/hardware/laser/wall-right-iec.dxf

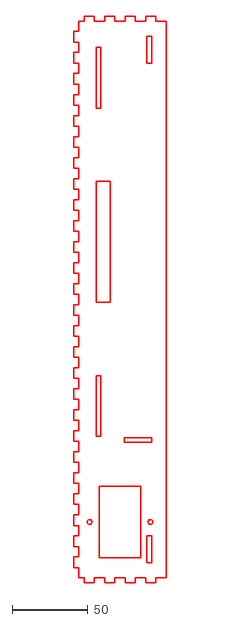
[picture p92: CAD file, 2026-10-18]
hardware/laser/wall-right-iec.dxf
60.7 x 373.0
