jof/patternflood/hardware/laser/bezel-inner.dxf

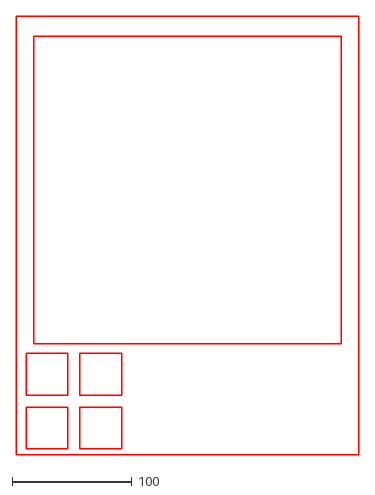
[picture p93: CAD file, 2026-10-18]
hardware/laser/bezel-inner.dxf
286.6 x 366.6
