jof/patternflood/hardware/laser/rail-b-hex-pocket.dxf

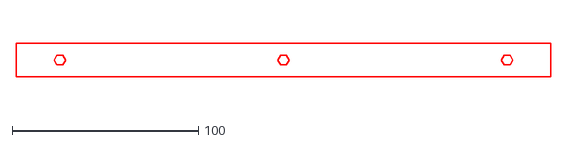
[picture p94: CAD file, 2026-10-18]
hardware/laser/rail-b-hex-pocket.dxf
286.6 x 18.0
