jof/patternflood/hardware/laser/rail-c-tenoned.dxf

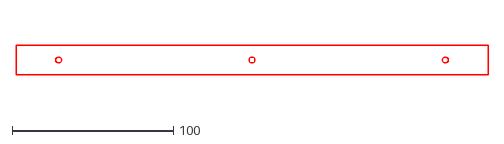
[picture p95: CAD file, 2026-10-12]
hardware/laser/rail-c-tenoned.dxf
293.0 x 18.2
