jof/patternflood/hardware/laser/panel-brace-middle.dxf

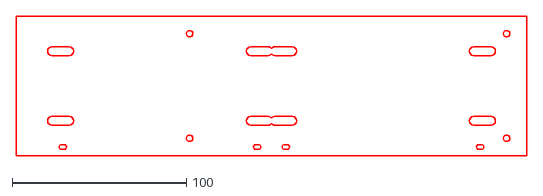
[picture p96: CAD file, 2026-10-12]
hardware/laser/panel-brace-middle.dxf
293.0 x 80.2
