jof/patternflood/hardware/laser/panel-brace-upper.dxf

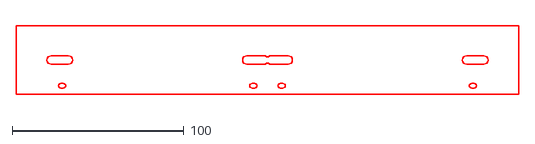
[picture p97: CAD file, 2026-10-12]
hardware/laser/panel-brace-upper.dxf
293.0 x 40.2
