jof/patternflood/hardware/laser/stiffener-web.dxf

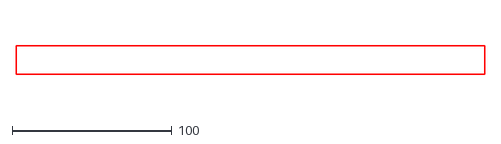
[picture p98: CAD file, 2026-10-12]
hardware/laser/stiffener-web.dxf
293.0 x 18.0
