jof/patternflood/hardware/laser/spacer-ring-tray-to-brace.dxf

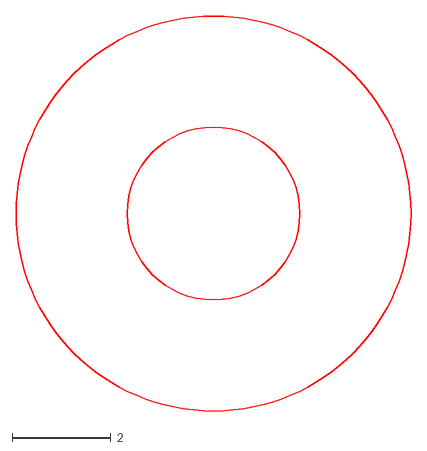
[picture p99: CAD file, 2026-10-12]
hardware/laser/spacer-ring-tray-to-brace.dxf
8.00 x 8.00
