jof/patternflood/hardware/laser/panel-brace-middle-middle-sheet-tray-nuts.dxf

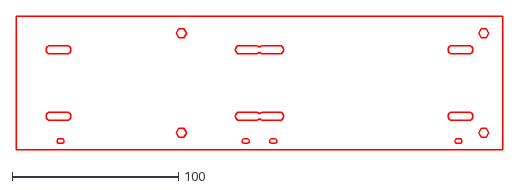
[picture p100: CAD file, 2026-10-12]
hardware/laser/panel-brace-middle-middle-sheet-tray-nuts.dxf
293.0 x 80.2
