jof/patternflood/hardware/laser/spacer-ring-board.dxf

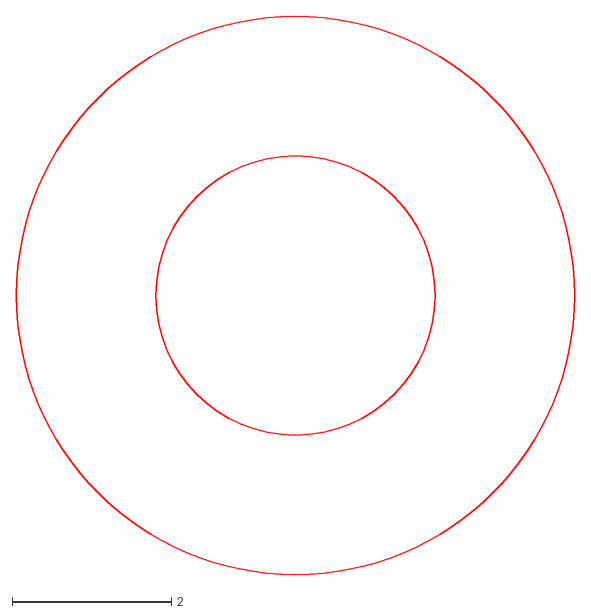
[picture p101: CAD file, 2026-10-12]
hardware/laser/spacer-ring-board.dxf
7.00 x 7.00
