jof/patternflood/hardware/laser/panel-brace-lower.dxf

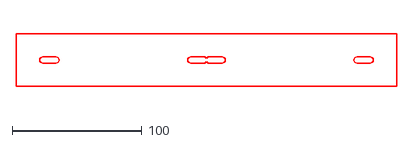
[picture p102: CAD file, 2026-10-12]
hardware/laser/panel-brace-lower.dxf
293.0 x 40.2
