jof/patternflood/(list of files, cad)

Other CAD files:
hardware/laser/rail-a-screw-clearance.dxf
hardware/laser/test-cuts/03-hex-nut-pockets.dxf
hardware/laser/test-cuts/04-captive-nut-sandwich.dxf
