jof/patternflood/docs/desktop/img/assembly-portrait.png

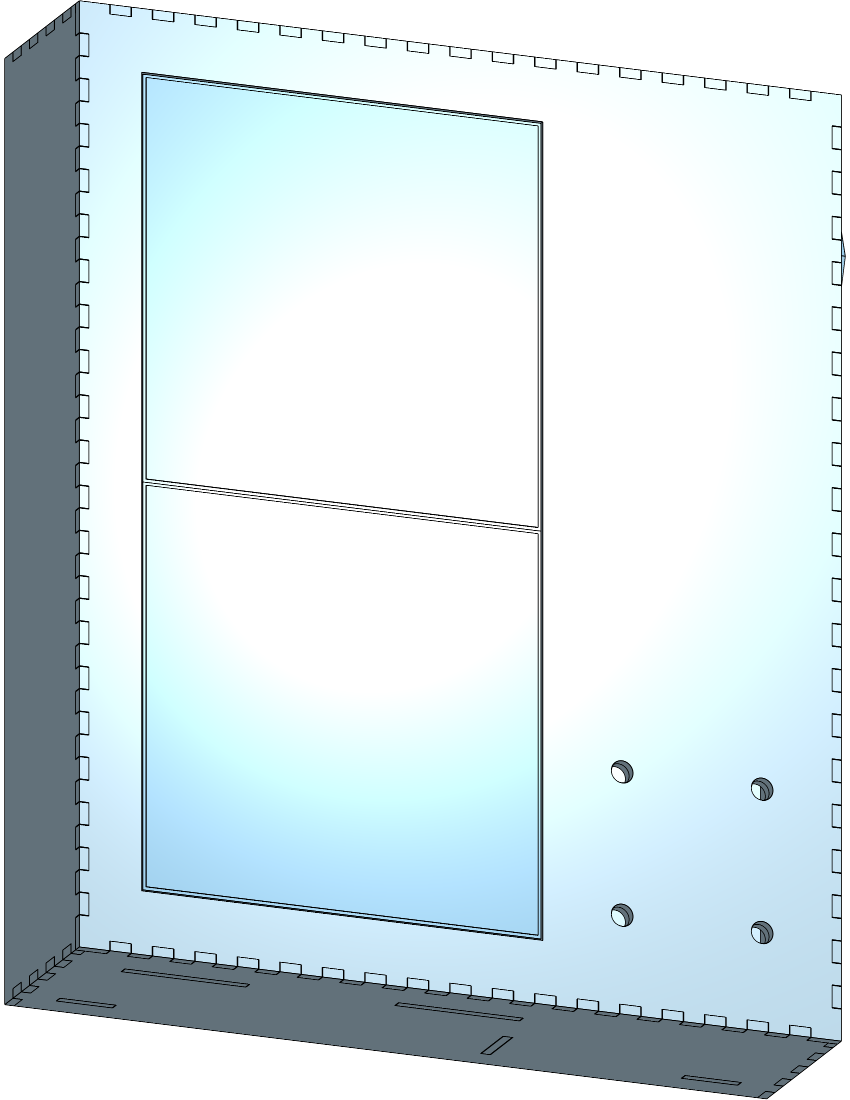
docs/desktop/img/assembly-portrait.png
