jof/patternflood/docs/desktop/img/assembly-rear.png

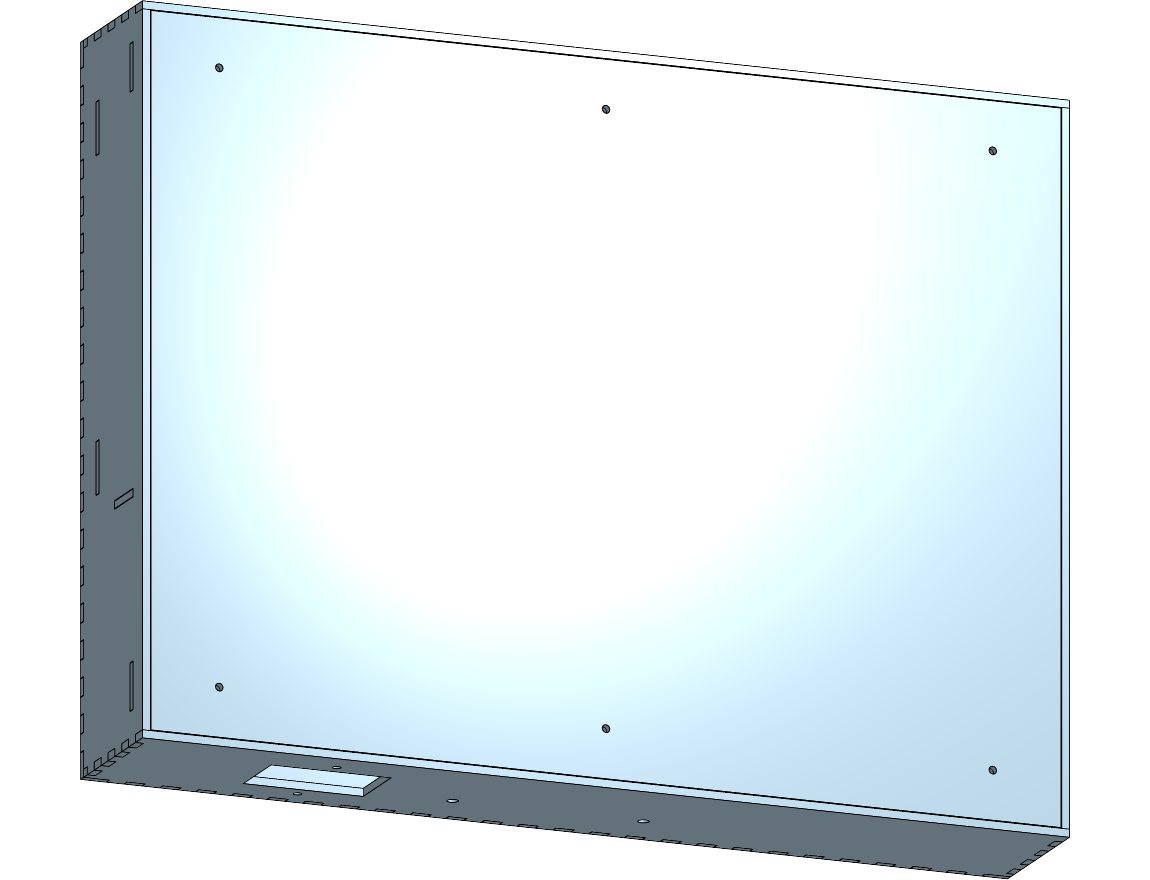
docs/desktop/img/assembly-rear.png
