jof/patternflood/firmware/demos/upstream_host/community_ports/84ce122b64d241eb.h

#pragma once

// ===== Patternflow pattern =====
// Title:    Fireworks
// Author:   @akacoda
// Source:   https://community.patternflow.work/community/p/84ce122b64d241eb
// SPDX-License-Identifier: CC-BY-SA-4.0
// ===============================
// Adapted for Patternflood's 128 x 128 panel (2026-10-27): the original's 128 x 64 sky,
// doubled in height. Everything that moves is scaled by SCALE = 1.6 (shell rise, burst and
// split speeds, gravity, drift), so the bursts open 1.6 times as wide with the same timing,
// and they carry 2.2 times the sparks (DENSITY; rings, which are lines, 1.6 times) so they
// read as full as the originals. The pools grow to match (1280 sparks, 1024 trail embers,
// found from a cursor instead of a scan from zero), sparks leave an ember every frame rather
// than half of them, shells go up a third more often over the taller sky, and the show
// opens with a pair of shells. Styles, palette, timing and the multi-break logic are the
// original's.

#include <Arduino.h>
#include "config.h"
#include "src/core_display.h"
#include "src/core_encoders.h"
#include "src/core_canvas.h"
#include "src/core_math.h"
#include "src/core_mem.h"

namespace Fireworks {

const char* NAME = "Fireworks";
const char* const KNOB_LABELS[4] = {"Rate", "Spread", "Size", "Gravity"};

constexpr int FRAME_W = 128;
constexpr int FRAME_H = 128;

static constexpr int FW_MAX_SHELLS = 14;      // the original: 10
static constexpr int FW_MAX_SPARKS = 1280;    // the original: 256
static constexpr int FW_MAX_TRAILS = 1024;    // the original: 128
static constexpr int FW_PIX_COUNT = FRAME_W * FRAME_H * 3;
static constexpr float SCALE = 1.6f;          // lengths and speeds, against the original's 64-high sky
static constexpr float DENSITY = 2.2f;        // sparks per burst (about SCALE squared, for an area)
static constexpr float LAUNCH_RATE = 1.35f;   // shells per second, against the original

static constexpr uint8_t STYLE_PEONY = 0;
static constexpr uint8_t STYLE_CHRYS = 1;
static constexpr uint8_t STYLE_WILLOW = 2;
static constexpr uint8_t STYLE_RING = 3;
static constexpr uint8_t STYLE_PALM = 4;
static constexpr uint8_t STYLE_CROSSETTE = 5;
static constexpr uint8_t STYLE_PISTIL = 6;

static constexpr uint8_t FW_PALETTE[11][3] = {
    {255, 60, 50},
    {255, 140, 40},
    {255, 220, 70},
    {255, 255, 200},
    {180, 255, 120},
    {50, 220, 90},
    {60, 200, 255},
    {70, 110, 255},
    {180, 80, 255},
    {255, 90, 180},
    {220, 220, 255},
};

static constexpr uint8_t FW_SECONDARY_STYLES[4] = {
    STYLE_PEONY, STYLE_RING, STYLE_CHRYS, STYLE_PISTIL
};

struct FwShell {
    uint8_t alive;
    float x, y, vx, vy;
    float targetY;
    float age;
    uint8_t style;
    uint8_t colorA;
    uint8_t colorB;
    float size;
    uint8_t breaksLeft;   // remaining delayed bursts after the first pop
    uint8_t glitter;
    uint8_t phase;        // 0 = rising mortar, 1 = hanging for delayed break
    float burstTimer;
};

struct FwSpark {
    uint8_t alive;
    float x, y, vx, vy;
    float life;
    float maxLife;
    uint8_t r, g, b;
    float drag;
    float gravity;
    uint8_t twinkle;
    uint8_t sparkle;
    uint8_t canSplit;
    float splitT;
    uint8_t trail;
};

struct FwTrail {
    uint8_t alive;
    float x, y;
    float life;
    uint8_t r, g, b;
};

static FwShell shells[FW_MAX_SHELLS];
static FwSpark sparks[FW_MAX_SPARKS];
static FwTrail trails[FW_MAX_TRAILS];

static float* pixBuf = nullptr;
static int32_t rngState = 12345;
static float spawnAcc = 0.2f;
static float nextLaunch = 0.4f;
static float skyPulse = 0.0f;
static float t = 0.0f;

static float fwClamp(float v, float a, float b) {
    return fmaxf(a, fminf(b, v));
}

static float fwRnd() {
    rngState = (rngState * 48271) % 2147483647;
    if (rngState <= 0) rngState += 2147483647;
    return static_cast<float>(rngState) / 2147483647.0f;
}

static float fwRandRange(float a, float b) {
    return a + (b - a) * fwRnd();
}

static void fwColorOf(uint8_t idx, uint8_t& r, uint8_t& g, uint8_t& b) {
    const uint8_t i = idx % 11;
    r = FW_PALETTE[i][0];
    g = FW_PALETTE[i][1];
    b = FW_PALETTE[i][2];
}

static void fwHeatTint(uint8_t r, uint8_t g, uint8_t b, float heat,
                       uint8_t& outR, uint8_t& outG, uint8_t& outB) {
    const float h = fwClamp(heat, 0.0f, 1.0f);
    outR = static_cast<uint8_t>(r + (255 - r) * h);
    outG = static_cast<uint8_t>(g + (255 - g) * h);
    outB = static_cast<uint8_t>(b + (255 - b) * h);
}

static int sparkCursor = 0;
static int trailCursor = 0;
static int trailsAlive = 0;

// The original scans from zero; with five times the pool that's a cost, so each search starts
// where the last one stopped.
static FwSpark* allocSpark() {
    for (int k = 0; k < FW_MAX_SPARKS; ++k) {
        const int i = (sparkCursor + k) % FW_MAX_SPARKS;
        if (!sparks[i].alive) {
            sparkCursor = (i + 1) % FW_MAX_SPARKS;
            return &sparks[i];
        }
    }
    int i = static_cast<int>(fwRnd() * FW_MAX_SPARKS);
    if (i >= FW_MAX_SPARKS) i = FW_MAX_SPARKS - 1;
    return &sparks[i];
}

static FwTrail* allocTrail() {
    if (trailsAlive >= FW_MAX_TRAILS) return nullptr;
    for (int k = 0; k < FW_MAX_TRAILS; ++k) {
        const int i = (trailCursor + k) % FW_MAX_TRAILS;
        if (!trails[i].alive) {
            trailCursor = (i + 1) % FW_MAX_TRAILS;
            trailsAlive++;
            return &trails[i];
        }
    }
    return nullptr;
}

static FwShell* allocShell() {
    for (int i = 0; i < FW_MAX_SHELLS; ++i) {
        if (!shells[i].alive) return &shells[i];
    }
    return nullptr;
}

static void spawnSpark(float x, float y, float vx, float vy,
                       uint8_t r, uint8_t g, uint8_t b, float life,
                       float drag, float gravity,
                       uint8_t twinkle, uint8_t sparkle,
                       uint8_t canSplit, float splitT, uint8_t trail) {
    FwSpark* p = allocSpark();
    p->alive = 1;
    p->x = x;
    p->y = y;
    p->vx = vx;
    p->vy = vy;
    p->life = life;
    p->maxLife = life;
    p->r = r;
    p->g = g;
    p->b = b;
    p->drag = drag;
    p->gravity = gravity;
    p->twinkle = twinkle;
    p->sparkle = sparkle;
    p->canSplit = canSplit;
    p->splitT = splitT;
    p->trail = trail;
}

static void burstShell(FwShell& shell);

static void launchShell(int w, int h) {
    FwShell* s = allocShell();
    if (!s) return;

    const float midY = h * 0.5f;
    const float targetY = fwRandRange(h * 0.08f, midY - 2.0f);

    s->alive = 1;
    s->x = fwRandRange(w * 0.12f, w * 0.88f);
    s->y = static_cast<float>(h - 1);
    s->vx = fwRandRange(-8.0f, 8.0f) * SCALE;

    const float rise = s->y - targetY;
    s->vy = -sqrtf(fmaxf(40.0f * SCALE * SCALE, 2.0f * 55.0f * SCALE * rise)) * fwRandRange(0.85f, 1.15f);
    s->targetY = targetY;
    s->age = 0.0f;
    s->style = static_cast<uint8_t>(fwRnd() * 7.0f);
    s->colorA = static_cast<uint8_t>(fwRnd() * 11.0f);
    s->colorB = static_cast<uint8_t>(fwRnd() * 11.0f);
    if (s->colorB == s->colorA) s->colorB = static_cast<uint8_t>((s->colorA + 3) % 11);
    s->size = fwRandRange(0.7f, 1.35f);
    // ~55% multi-break shells: 1-3 extra timed pops after the first burst
    if (fwRnd() < 0.55f) {
        s->breaksLeft = static_cast<uint8_t>(1 + static_cast<int>(fwRnd() * 3.0f));
    } else {
        s->breaksLeft = 0;
    }
    s->glitter = fwRnd() < 0.45f ? 1 : 0;
    s->phase = 0;
    s->burstTimer = 0.0f;
}

static void splitSpark(FwSpark& sp) {
    const int n = 4 + static_cast<int>(fwRnd() * 4.0f);   // the original: 3..5
    for (int i = 0; i < n; ++i) {
        const float a = fwRnd() * TWO_PI;
        const float speed = fwRandRange(12.0f, 26.0f) * SCALE;
        spawnSpark(sp.x, sp.y,
            cosf(a) * speed, sinf(a) * speed,
            sp.r, sp.g, sp.b, fwRandRange(0.35f, 0.7f),
            0.97f, 34.0f * SCALE, 0, 1, 0, 0.0f, 0);
    }
    sp.alive = 0;
}
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
