jof/patternflood/firmware/demos/upstream_host/web_ports/preset_0519_2.h

// SPDX-License-Identifier: CC-BY-SA-4.0
// Pattern: 0519-2
// Author:  Seunghun LEE
// Lineage: AI generated and curated
// Ported for Patternflood from web/src/lib/presets/pattern-0519-2.ts (web-only upstream; not an upstream port)
//
// Glitch typography on matrix grid.
//
// Knobs for Glitch Typography:
// Knob 1: Glitch Preset (10 distinct modes: 0.0=Clean to 1.0=Meltdown)
// Knob 2: Overall Pattern Speed (Animation speed of background, 0.1 - 10.0)
// Knob 3: Motif Density (Scale of the underlying shapes, 0.0 - 4.9)
// Knob 4: Chromatic Aberration (RGB channel splitting width, 0.0 - 1.0)

#pragma once
#include <Arduino.h>
#include <math.h>
#include "../config.h"
#include "../src/core_display.h"
#include "../src/core_encoders.h"
#include "../src/core_canvas.h"
#include "../src/core_params.h"

namespace Pattern05192 {
  const char* NAME = "0519-2";
  const char* const KNOB_LABELS[4] = {"Glitch Mode", "Speed", "Density", "Aberration"};
  constexpr bool ABSOLUTE_READY = true;

  // patternTime only feeds sin(0.5 t + ..), and glitchTime only feeds sines
  // with integer multipliers or 1.5: both are periodic over 4π.
  constexpr float P05192_T_PERIOD = 4.0f * (float)M_PI;

  struct Params {
    // Raw knob state, at the web's default ranges and starting values.
    float rawKnob0 = 0.0f;   // [0, 1], wraps
    float rawKnob1 = 2.0f;   // [0.1, 10]
    float rawKnob2 = 0.0f;   // [0, 4.9]
    float rawKnob3 = 0.06f;  // [0, 1], wraps
    double patternTime = 0.0;  // host port: double/sin-hash kept for fidelity to the JS; not ESP32-friendly
    double glitchTime = 0.0;
    int glitchPreset = 4;
    int cellSize = 12;
    double aberration = 5.0;
  };
  Params params;
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
