jof/patternflood/(commit log)

2026-09-06 Plan a Patternflow fork on Matrix Portal S3 with lidar
    Planning docs for a personal Patternflow build. Keeps upstream's 128x64
    pixel geometry — so every existing pattern runs unmodified — while
    replacing the controller, the control surface and the power path, and
    adding a 3D lidar as the one genuinely new feature.
    Hardware delta vs upstream v3.9:
    - Adafruit Matrix Portal S3 instead of the custom ESP32-S3 carrier PCB
    - 2x Waveshare P2 64x64 GOB (256x128 mm) instead of 1x P2.5 320x160 mm
    - 4x Adafruit 4991 seesaw encoders on I2C instead of EC11 on GPIO
    - USB-C into a sealed internal bank instead of an external power bank
    - LD2450 radar + VL53L9CX 3D lidar; upstream has neither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
2026-09-06 Split into two projects: desktop Patternflow and room-interactive wall
    The combined build was compromising on every axis at once — battery vs
    200 W, instant-on vs a Linux boot, knobs vs a depth camera, tracking
    upstream vs diverging from it. Splitting resolves all of them.
    docs/desktop/ — Project B, ready to build
    2x P2 64x64 GOB, Matrix Portal S3, 4x seesaw encoders, USB-C.
    Keeps upstream's 128x64 geometry and tracks upstream's tree.
    docs/wall/ — Project A, concept, blocked on the lidar breakout
    9x P3 64x64 (192x192 px), VL53L9CX over I3C, Pi + RP2350, mains.
    New codebase; borrows the idea, not the code.
    The technical hinge is I3C. The VL53L9CX does I2C at 1 MHz or I3C at
    1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
2026-09-06 Add desktop build prep; correct two claims it contradicts
    An ordered prep plan for the desktop build, sequenced so nothing waits
    on a delivery: bench work first (needs only what's on hand), then a
    caliper session, then the shopping list.
    Two corrections found while writing it.
    features/overrides.h cannot carry this port. config.h states that every
    tunable in it is #ifndef-guarded; only 12 symbols actually are — the
    sleep settings and the gamma/white-balance/saturation constants. The
    HUB75 pins, PANEL_RES_*, PANEL_CHAIN, the encoder pins and
    DEFAULT_BRIGHTNESS are all bare #defines, so the port has to patch
    config.h and platformio.ini directly. Recommend keeping that delta as a
    git format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
2026-09-07 Add desktop branch, patch series, and laser-cut enclosure design
    Firmware fork now exists rather than being described. upstream/ carries a
    `desktop` branch off the pinned 87700bd, and the delta is exported to
    firmware/patches/ with the workflow in firmware/README.md.
    Correct PANEL_CHAIN — it stays 1, and the panel config needs no change.
    Earlier docs said to set PANEL_CHAIN 2 for the two chained 64x64 panels.
    That is wrong. core_display.h passes PANEL_RES_W to the driver as the
    module width, so physical width is PANEL_RES_W * PANEL_CHAIN — but
    PANEL_RES_W is simultaneously the canvas width in core_canvas.h,
    core_tables.h and the module ABI's array bounds. The two uses agree only
    when c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
2026-09-07 Add Onshape workflow and vendor CAD for the desktop enclosure
    How to get the hardware into Onshape and design the box around it.
    Vendored two STEP models from adafruit/Adafruit_CAD_Parts (MIT), which
    indexes 472 parts by product ID:
    5778 Matrix Portal S3 3.9 MB
    4991 QT Rotary Encoder 1.8 MB
    Those were the only BOM parts present. The PID 377 encoder, both knob
    sets and the STEMMA QT cables are not in the repo, and no Waveshare panel
    model is published, so those are proxies — which is the right fidelity
    anyway. A laser-cut box needs envelopes and mounting features, not
    detail, and proxies rebuild faster and keep dimensions under your control.
    The document structure leads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
2026-09-07 Model the desktop bezel and panel proxy in Onshape
    Adds hardware/cad/featurescript/enclosure.fs — the parametric source for
    the desktop enclosure, authored here and uploaded to Onshape rather than
    drawn in the browser. Two features so far:
    panelProxy two butted Waveshare P2 64x64 modules as a plain envelope
    bezel the doubled front face: display aperture, four knob bores,
    and a control band below the display
    Establishes the datum convention everything else depends on: z=0 is the
    LED panel front face, z<0 into the enclosure, z>0 the bezel laminations,
    with x=y=0 at the centre of the display.
    The bezel emits one solid per lamination rather than a single 6 mm plate,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
2026-09-07 Add box walls with kerf-compensated finger joints
    Third feature in enclosure.fs: four walls forming a rectangular tube along
    z, finger-jointed to each other at the four vertical corners, plus the
    generic joint helper they are built on.
    The mechanism: two perpendicular plates meeting at an edge overlap in a
    rectangular prism. Slice that prism along the joint and give alternating
    slices to each plate — cut the even slices from one, the odd from the
    other — and they interlock with no interference. Left/right walls take
    phase 0 at every corner and top/bottom take phase 1, so the alternation
    stays consistent the whole way round.
    Kerf compensation is the part worth getting right. A laser rem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
2026-09-07 Merge bezel and walls into one shell feature with front-edge joints
    Replaces the separate bezel and boxWalls features with a single
    enclosureShell. The front-edge finger joints couple the bezel to the
    walls, so two features would each have to derive the same finger layout
    independently and could silently disagree about it.
    Construction: inner laminations are inset by one thickness so they drop
    inside the wall tube and self-locate the bezel against the panel face;
    the outermost lamination is full-footprint and finger-joints into the wall
    front edges. Walls now run z -33..+6 rather than stopping at the panel
    face, so there is material for those joints to bite into.
    Three joint families: the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
2026-09-07 Add panel cross-braces with screw slots and wall through-tenons
    The panels now hang from two braces rather than from the bezel. Each brace
    lies flat against the panel backs at z -18..-15 and carries M3 screws
    driven from BEHIND, forward into the panels' own rear threaded posts, so
    the load path is brace -> through-tenon -> side wall and the bezel stays
    purely cosmetic.
    Screw holes are obround, running in x. Panel post positions shift between
    production runs and are not published, so the slot absorbs the error;
    braceYOffset (59mm) and postXOffset (54mm) are placeholders until measured
    off the actual panels.
    Each brace spans the full box width as a through-tenon, ending flush with
    the outsid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
2026-09-07 Add removable back cover on captive hex nuts; bayDepth 18 -> 25mm
    The finger joints get glued. The back does not, so it needs a fastening
    that survives being opened repeatedly — wood screws into 3mm basswood
    would strip after a few cycles.
    Solution is a three-layer sandwich at the rear, all laser-cut, nothing
    threading into wood:
    z -40..-37 back cover removable, 6 x M3 clearance
    z -37..-34 rail A hex pocket, nut drops in at assembly
    z -34..-31 rail B solid backer, traps the nut for good
    Rail A's pocket is a through-cut so the nut can be inserted; rail B glues
    behind it and the nut can then neither spin nor fall out. The screw pulls
    against a steel nut for the life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
2026-09-07 Fix back cover fastening: the nut was backed on the wrong side
    The previous arrangement did not work, and would have shipped a back cover
    that simply fell off.
    Tightening pulls the nut TOWARD the screw head, but the backer lamination
    was on the far side of the nut. So the nut would have been drawn forward
    against the cover's inner face while the head bore on its outer face — the
    screw and nut clamping the cover to itself, with nothing connecting either
    to the box.
    The nut has to bear against material on the side it is pulled toward, with
    only a clearance hole through it. That is a counterbore, and a single
    laser-cut sheet cannot make one, so the rail is now three laminations:
    z -40..-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
2026-09-07 Flush-mount the LEDs; ground panel post positions in measured data
    Two changes driven by the same question — where the panel actually sits.
    Flush LEDs. The bezel previously stood 6mm proud with the display in a
    shadowbox recess. The front plane is now z = 0 and the bezel hangs BACK
    from it, with the aperture cut LARGER than the panel so the panel passes
    through and its own face forms part of the front surface. Verified:
    frontmost geometry sits at z = 0.00, panels and bezel coplanar. External
    depth drops 46 -> 40mm since the bezel no longer adds to the stack.
    apertureGap is signed, so this is one variable to reverse: +0.5mm clears
    the panel and gives flush, negative laps the bezel over th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
2026-09-07 Model the Voltaic V50 bank, velcro mounting and USB-C inlet
    Bank selection. Pass-through plus always-on plus >=36W output is an empty
    set, so this is a considered compromise. The V50 (118 x 82 x 26mm, 48Wh)
    documents both pass-through and an always-on mode at ~7mA idle, which is
    what stops Patternflow's sleep mode letting the bank shut off.
    Its ceiling is ~20W. Waveshare rates each P2 64x64 at 5V/3A, <=15W, so the
    pair's rated max is 30W, and upstream measured 24W for real full white on
    the same 8192 pixels. After the buck the V50 gives ~18W, so every
    realistic pattern runs at full brightness and only near-full-white frames
    clamp — roughly 72% of measured full white, 60% of rated. That pr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
2026-09-07 Model bay obstructions: connector keep-outs and the Matrix Portal
    Adds a bayObstructions feature emitting proxies for everything already in
    the bay, so anything else put there is checked rather than assumed to fit.
    Per panel, one generous connector keep-out covering the HUB75 IN and OUT
    headers plus the JST power connector — positions are unpublished and vary,
    so one envelope to be measured and shrunk rather than individual bosses.
    The Matrix Portal is the one that matters, and modelling it changed the
    picture. It does not sit against the panel; it rides ON the HUB75 header,
    so it reaches ~20mm behind the panel back. Footprint 77.5 x 53.5 measured
    from the vendored Adafruit STEP (77.47 x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
2026-09-07 Vendor HUSB238 PD sink CAD; record STEP-measured envelopes
    The HUSB238 breakout answers the "USB-C into a PD sink that can hold a
    terminal block" question directly: it carries the USB-C receptacle and a
    screw terminal block on one board, so no separate panel-mount extension
    and no soldered power joints.
    Vendored both variants from Adafruit_CAD_Parts (MIT):
    5991 I2C / switchable, STEMMA QT 29.1 x 20.3 x 10.1
    5807 I2C / fixed 24.5 x 20.2 x 4.9
    Measured from the 5807 STEP: PCB 1.57mm, and two Ø2.5 (M2.5) mounting
    holes on 15.24mm / 0.6 inch centres at the end OPPOSITE the receptacle —
    which is what makes it mountable flat with the receptacle butted to a wall
    cutou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
2026-09-09 Separate panel body from tiling pitch; record measured P3 hole pattern
    Measured panels, 2026-09-08, which corrected an assumption I had baked in
    throughout.
    I modelled panelW = 128 as the panel BODY. It is the tiling PITCH. The
    bodies are deliberately undersize and the gap between them is REQUIRED,
    not slop: each panel carries a half-gap border between its edge pixel
    centre and its edge, so border + gap + border must equal one pixel pitch
    or the grid jogs at every seam.
    Measured on a Waveshare P3 64x64 and it closes exactly:
    64 px x 3mm -> 189mm first-to-last pixel centre
    body 190 = 189 + 2 x 0.5mm border
    0.5 + 2.0 + 0.5 = 3.0mm -> continuous grid
    190 + 2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
2026-09-09 Switch to mains: LRS-50-5 and IEC inlet, with measured data
    Supersedes the bank and USB-C PD work. Mains AC in through an IEC C14
    module with switch and fuse, to a chassis-mounted Mean Well LRS-50-5.
    Sections 0-7 of the power plan are kept for reasoning but their parts
    lists are dead.
    Data pulled from the Mean Well spec sheet (Case 239A) rather than
    listings: 99 x 82 x 30mm, 210g, 5V 10A, 83% efficient, 2 x M3 per side
    face 74mm apart with a 5mm max penetration, 2 x M3 on the base 55mm apart
    at 3mm max, and a 5-pin terminal block ordered AC/L, AC/N, FG, -V, +V.
    Inrush 45A at 230VAC, derating from ~40C.
    The IEC module resolved from the Amazon listing as an IEC320 C14 with
    rocker and 5x20mm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
2026-09-09 Tall layout: PSU compartment, divider shelf, IEC inlet
    Chosen over the deep alternative, which would have kept the 296 x 193 face
    but taken depth from 40 to ~68mm. The face grows instead: external is now
    296 x 287 x 44.5mm.
    The LRS-50 could not go in the bay at all. Its 82mm dimension exceeds
    every clear band there — 61.5mm above the panel connector keep-outs and
    68.5mm below them — and a 99mm-tall orientation spans across the keep-outs
    wherever it is centred. Hence a compartment of its own.
    Adds a divider shelf on the control band's lower edge, through-tenoned
    into both side walls. It does three jobs and the third is why it is not
    optional: it stiffens a much taller box, it carries th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
2026-09-09 Cluster the knobs so the PSU shares the control band
    Replaces the separate mains compartment. The knob row spans only 135mm of
    a 290mm band, so clustering it to the left leaves the right-hand end for
    the supply. External height drops 287 -> 244mm and the box loses a whole
    compartment.
    controlH is now sized by the PSU rather than the knobs: 3 bottom wall + 5
    standoff + 82 PSU + 3 clearance + 3 pocket rail = 96mm. Because of that
    the knobs are no longer centred in the band — centring them in a
    PSU-sized band would drop them oddly low — so they hang off the aperture
    edge at knobYOffset instead.
    The mains barrier turns from a horizontal shelf into a VERTICAL divider
    plus a short rail acros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
2026-09-09 2x2 knob cluster, which is what makes room for the IEC inlet
    Fixes a collision I had shipped: the IEC module protrudes ~30mm behind its
    panel, and with a full-width knob row the gap between the PSU and the
    right wall was 10.5mm. The module simply did not fit.
    Four knobs in a 2x2 block occupy 70mm of band width against 160mm for a
    1x4 row, and that 90mm is precisely what was needed. Re-laid the band:
    knob cluster -130.2 .. -59.8
    divider -51.6 .. -48.4 8.2mm clear of the knobs
    PSU -44.5 .. 54.5 3.9mm clear of the divider
    IEC zone 54.5 .. 145.0 90.5mm, against ~30mm needed
    Knob index order is now reading order — K1 top-left, K2 top-right,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
2026-09-10 Apply measured IEC dimensions; model its envelope
    Measured 2026-09-09: cutout 46.75 x 27.25, depth behind the face 37.45mm.
    The listing figures were wrong on all three counts.
    The 46.75 dimension must run along y — the pocket is only 35.5mm in z —
    which leaves ~4.1mm of margin at both the bezel and the back cover.
    Modelled and verified in place:
    IEC envelope 37.45 x 46.75 x 27.25
    x 110.55..148 y -133.37..-86.63 z -37.37..-10.13
    37.45mm is also the number that justifies the 2x2 cluster after the fact.
    A full-width knob row left 10.5mm between the PSU and the right wall, so
    the module could not have gone in at all; clustering freed 90mm and the
    body now stops 56mm clear of the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
2026-09-10 Model the IEC flange; it does not fit a side wall
    Flange modelled from measurement as a hexagonal outline — 6.25mm overhang
    beyond the cutout on the short sides, and a shallow triangular lobe on
    each long side peaking 10.75mm out at the middle with the screw hole in
    it. Built as a sketched polygon and extruded 3.5mm proud of the face.
    Verified: 3.5 x 59.25 x 48.75, 8 faces, which is the 6 side faces of a
    hexagon plus front and back.
    Modelling it settled the screw-spacing contradiction. The screws are on
    the SHORT axis, not the long one, which is why 40mm could never straddle a
    46.75mm cutout — I had the axis wrong, not the number. Derived spacing is
    cutH + tip = 38mm (hole at the lobe's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
2026-09-10 Derive case depth from the IEC flange rather than picking it
    The box now follows the insides. bayDepth stops being a chosen number and
    becomes derived from the deepest thing that has to fit:
    bayDepth = iecCutH + 2*iecFlangeTip + 2*iecFlangeMargin - panelDepth
    giving 42.25 and an external depth of 56.75mm, up from 44.5. For contrast
    the bay itself wanted ~40.6mm and the connector keep-out ~37.5mm — the
    flange was the only thing asking for more, and it was asking by a lot.
    Verified the flange now seats:
    flange z -52.75 .. -4.00
    wall z -56.75 .. 0.00 4.00mm margin at both ends
    overall 299.5 x 244 x 56.75 (299.5 in x includes the flange 3.5mm proud)
    26 bodies, no fragment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
2026-09-10 Remove duplicated IEC envelope; derive depth from PSU clearance
    The "weird boxes" were mine. I had added an IEC envelope to
    bayObstructions, then later built a proper iecProxy that models the same
    module with its flange — so two overlapping boxes sat in the pocket. The
    bayObstructions copy is gone; body count 26 -> 25.
    Depth re-derived, and it now comes from the PSU rather than the flange:
    bayDepth = (0 - psuZFront) + psuT + psuRailClear + 4*thickness - panelDepth
    which is the PSU's front offset, its 30mm body, the clearance behind it,
    and the four sheets of back cover plus rails A/B/C. 60mm external, up from
    56.75.
    That fixes a genuinely tight spot. The PSU rear sat 6.75mm off the f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
2026-09-10 Drill the IEC flange; fix a Matrix Portal / PSU collision
    Two fixes from visual review.
    The flange had no screw holes. The wall was drilled but the flange proxy
    was not, so the model showed screws passing through solid material —
    exactly the sort of thing a proxy exists to catch, and it only showed up
    because the flange was modelled rather than dimensioned. Flange now
    reports 10 faces with 2 cylindrical: the hexagon's 8 plus the holes.
    The Matrix Portal was intersecting the PSU by 33.4 x 11.7 x 19.1mm and
    passing straight through the pocket rail. Cause was a stale position:
    the board sat at mpY -55, chosen when the clear band below the connector
    keep-outs ran down to y -88.5. Clustering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
2026-09-10 Drop the mains divider for insulation; fix the PSU hole datum
    Mains barrier removed. It obstructed assembly and was solving the problem
    indirectly: the LRS-50's input terminal block is the only exposed mains
    point in the build, since everything else is already inside the supply's
    metal case, the IEC module's plastic body, or insulated wire. A terminal
    boot plus heatshrinked fork terminals protects that point directly, and is
    a recognised method rather than a shortcut.
    The barrier's other job was stopping a loose conductor migrating into the
    low-voltage side, so strain relief and tie-downs are promoted from good
    practice to required in power-plan.md §9.
    Kept the divider's structural job in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
2026-09-10 One vertical brace only; side holes are not collinear
    Horizontal mid rail removed as asked — one vertical web, no conflict. Body
    count 25 -> 24.
    Worth being straight about the intersection: my bounding-box check did not
    reproduce it. The mid rail sat at y -67.1..-63.9 and the back-cover rail
    stacks at y -157..-139 and 63..81, so they shared a z band but never a y
    band. Removed regardless, since one brace is enough and the vertical web
    covers the longer span. But note the WEB does cross both rail stacks by
    design, notched via a boolean against them, so if that crossing is what
    looked wrong then it is intentional and it is now the only one left.
    The two PSU side-face holes are NOT collinea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
2026-09-10 Swap the brace 90 degrees: horizontal, not vertical
    I removed the wrong one last time. The back-cover rail stacks run
    HORIZONTALLY along the top and bottom edges, so a vertical brace has to
    cross both of them — no lateral position avoids it, only notching, which
    is what made the vertical web fight them. A horizontal brace is parallel
    to the rails and sits between them, so it cannot clash at any depth.
    Single horizontal brace now, just under the display aperture at
    y -67.6..-64.4, z -57..-39. That y band is the one place clear of
    everything: 3mm above the PSU, 0.5mm below the panels, clear of the knob
    cluster, and between both rail stacks. 18mm deep at the rear leaves ~33mm
    at the front fo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
2026-09-11 Use the LRS-50's threaded M3 side holes: one collinear row
    The side mounting holes on the LRS-50-5 are threaded M3 and collinear,
    so ordinary M3 screws bolt straight in from the bottom panel -- no
    slots, no inserts, no second hole height. Reverts the split-height pair.
    psuHoleDia 4 -> 4.5 mm: +-0.75 mm of play per hole absorbs the drawing's
    +-1 mm position tolerance across the 74 mm span.
    Verified after re-instantiating all five features on the fresh
    namespace: 24 bodies, 0 fragments, 299.5 x 244 x 60 mm. Both PSU holes
    land at z=-22.5, 74 mm apart, drawn at r=2.15 (4.5 mm less kerf).
2026-09-11 Model the PSU's threaded side holes on the proxy
    Blind Oe3 pockets in the LRS-50's low-y face, on the same datums the
    shell uses: x from the terminal end, height down from the front face.
    Verified coaxial with the wall's clearance holes at x -29.38 / 44.62,
    z -22.5, 74mm apart.
    Depth is the spec sheet's L = 5mm MAX PENETRATION, not a target -- as a
    blind pocket it makes the limit visible, and the screw length now falls
    out of the model: 3mm wood + 5mm psuStandoff + 5mm max = M3 x 12.
    Corrects power-plan.md, which said M3 x 6 and ignored the standoff.
2026-09-11 Move the IEC inlet to the bottom wall for the portrait orientation
    Portrait is the orientation this lives in, and stood on end the box
    rests on a +/-x wall -- so an inlet in the right-hand wall sat directly
    under the case and the mating plug jacked it off the table. The bottom
    wall is a vertical side in portrait, so the cord exits horizontally and
    no feet are needed. Landscape now rests on the inlet instead; the +y top
    wall is the only one that is a side in both, but it routes mains
    diagonally across the box past the Matrix Portal, which is worse.
    iecProxy rebuilt y-normal: body reaches inward in +y, flange sketched on
    the outer face with normal (0,-1,0) -- xDirection +x makes the sketch's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
2026-09-12 Pull the rear rails inward: no mortise near an edge or a notch root
    Two separate ways the rail mortises were uncuttable, one per axis.
    In z: rail A sits one thickness from the wall's rear edge, so tenoning
    it -- the obvious choice, since it is the rail the nut bears on -- left a
    3mm sliver along an 18mm slot. Moved the tenon to rail C, 3t in, with
    9mm of wall behind it.
    In y: the rails were flush against the top and bottom walls, so the
    mortise's near edge landed exactly on y=-157, which is also where the
    notches for those walls' fingers bottom out. A notch under the slot
    leaves no material at all. New #railInset = 10mm gives 9.9mm.
    The stiffener mortise had the same 3mm sliver and now st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
2026-09-13 Fastener concepts: can the box go together with M3 hardware and no glue?
    Five schemes for review, no model changes. Two pieces of arithmetic rule
    out most of the standard laser-cut vocabulary at 3mm: an M3 cross-hole is
    wider than the tab it goes through (no T-slot joints), and a standard M3
    washer embeds in basswood at 70N (no usable preload). What remains is a
    retained assembly rather than a clamped one.
2026-09-13 Model Concept B: laminated corner post, bolted one way and tusked the other
    The glueless corner drawn at full scale on the enclosure datum, as its own
    Feature Studio and Part Studio so it cannot destabilise the shell.
    Corrects section 1.1, which had the right conclusion for the wrong reason.
    The real rule is that a laser drills only along a sheet normal, so a bolt can
    only ever join two PARALLEL plates - a corner between perpendicular walls needs
    an intermediary, and that is the post. T-slot joints fail separately, because
    a captive nut's 5.5mm across-flats has to fit inside the sheet thickness.
    Corollary that shapes the design: where a bolt can pass right through into open
    air, a plain nu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
2026-09-13 Material survey: 30W is not the constraint, and ply retires the last glue joint
    At 3mm a 30W CO2 cuts every candidate; the power limit bites at 6mm, which
    this design never asks for. So the choice is on properties, not the laser.
    The deciding argument is not strength. Plywood is already cross-plied, which
    deletes the reason the front face still wanted glue (fastener-concepts 6.5) and
    makes a fully glueless box reachable. It also retires the cross-grain doubler
    rule, cuts seasonal movement from ~3% to ~0.2%, and 3mm Baltic birch is actually
    3.0mm where basswood runs 2.7-3.2 - which the finger joints care about more than
    they care about strength.
    Recommends 3mm Baltic birch B/BB, hard maple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
2026-09-13 Real proxies for the panel and PSU, and two vendor models to check them against
    Panel and PSU proxies gain a Detailed switch. Off is the plain envelope every
    clearance check was written against; on gives the GOB module, the lit area as
    its own body for emissive renders, PCB, rear frame, driver ICs, HUB75 headers
    and M3 posts - and for the PSU, vents, Vadj and the terminal block.
    Then the user found vendor CAD for both, so the proxies got checked rather than
    admired, and two things were wrong:
    - psuHoleZ was 14.5; Mean Well's STEP says 15, dead centre of the 30mm height.
    - The terminal block is FIVE ways at 9.3mm pitch, not seven at 9.5, and its
    screws tighten out through the top COVER, n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
2026-09-13 Record the panel SKU and the pixels-vs-millimetres arithmetic
    33838 is 2mm pitch x 64px = 128x128mm. '64x64' is the pixel count and reads
    like a size, which is exactly how the P2.5 model (also 64x64 px, but 160x160mm)
    looked like a candidate. Written down so it does not have to be re-derived.
    Also notes the one thing the P2.5 model corroborates: its inset is 10.3% of the
    body, which scaled onto 128mm puts the posts at 50.8mm from centre against our
    assumed 50.
2026-09-13 Model at P2.5: design against measured geometry, not four placeholders
    Panels are 160x160 rather than 128x128, so the box goes 296x244 -> 359.5x275.5.
    Depth is unchanged at 60 - it is PSU-driven, and bayDepth subtracts panelDepth.
    The reason is not that P2.5 is preferred. It is that a measured vendor model
    exists for P2.5 and P2 is still guesses, and designing against real geometry
    once beats designing against placeholders twice. Pixel geometry is 128x64
    either way, so firmware and patterns are untouched.
    postXOffset and braceYOffset move 50 -> 63.5, off the model's actual holes -
    the first mounting data this project has had that is not an extrapolation.
    Checked the model body by body bef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
2026-09-13 Split the model: one Part Studio per solve, one Assembly for placement
    Names all 16 enclosure parts and publishes mate connectors from the
    FeatureScript, then builds a real assembly: the 16 parts plus the LRS-50 (as a
    sub-assembly so it arrives as one instance, not 31) and two panels.
    Diverges from part-studio-per-part on purpose. A finger joint is one geometric
    solve across every panel at that edge, so splitting the walls would derive the
    notch layout twice with no way to notice a disagreement short of cutting wood.
    The line goes at solve vs placement, not at part.
    No in-context references needed: the Variable Studio is already the interface
    between the two, so both read the same numbers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
2026-09-13 Fix the panels: a vendor assembly tab does not share its part studio's frame
    Both panels went in backwards - PCB rear facing out through the aperture -
    because the transform came from the part studio (connectors at +z) while the
    element actually inserted was the assembly (connectors at -z). Identity
    rotation and t=(-+80, 0, -2.21) seats them LED-face-forward and flush.
    Corrects the 25mm panel depth reported last commit: it is 17.6mm. The 25 was
    an artefact of the bad transform. Against panelDepth 15 that is a 2.6mm gap,
    not 10.
    Renames the old scratch assembly rather than deleting it. It holds 66
    instances - everything twice, 30 untransformed LRS-50 bodies outside the box,
    and two coincide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
2026-09-13 Drop the vendor panel model, and stop push from silently killing the assembly
    Two separate faults behind 'components on both sides of the panel'.
    The vendor panel model is internally inconsistent: LED_Matrix at z 1.61..2.21
    is a 0.6mm plate with no LEDs, while IC_Connector_Layer spans -15.40..+0.98 and
    puts HUB75 shrouds forward of the board. 25,182 occurrences for one panel.
    Replaced with a Panel P2.5 part studio holding our own panelProxy, wrapped in an
    assembly so it inserts as one instance. Occurrences: 25,182 -> 88. The vendor
    tab stays for the one thing it got right, the mounting holes at +-63.5.
    The enclosure parts had also gone invisible. Cause: push.sh deleted and re-added
    every f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
2026-09-13 IEC AC-14-F16A: close the last UNKNOWN variable, and put the inlet in the assembly
    iecScrewSpacing was the only variable still marked UNKNOWN. The AC-14-F16A
    model in public doc a0851c0b has two 3.5mm flange holes at x -6.3 and +33.7:
    40.0mm apart. The derivation it replaces - cutH + flangeTip, screws in the
    middle of each lobe - gave 38, and a 3.4mm clearance hole would not have
    absorbed the 2mm error. The inlet would not have bolted on.
    Only that number is taken. The same model disagrees with our calipers by ~1mm
    across the flange and 7mm in depth, so the measured cutout and depth stand.
    That is now the written rule in the vendor README: take the one number a
    third-party model is authorit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
2026-10-04 Model at P2: the panels are on the bench, and they are not what we assumed
    Waveshare RGB-Matrix-P2-64x64-B, measured 2026-10-03. Box is now
    297 x 245 x 60 (was 359.5 x 275.5 at P2.5), lived in stood on end.
    The front face is 128.0 on a 128 pitch: zero seam gap. The P3 had taught the
    model "the body is undersize", but what generalises is border + gap + border
    = pitch - P3 splits it 0.5 + 2 + 0.5, this panel 1 + 0 + 1. #panelGap is
    derived, so it just went to zero; the proxy's lit-area border was the only
    thing that had hard-coded the old rule. Back face is 127, so neighbours touch
    only along the front edge. Depth 14.5, 17.8 over the pins.
    Not four corner posts: six M3 inserts, (+-57, +-44)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
2026-10-04 Confirm the pin edge: measured "top" is the panel's marked top
    The registration pins were modelled at +29 on the assumption that the edge
    measured as "top" was the panel's own top. It was, so they stay in the upper
    brace and nothing moves. The one check left is at first light: chain pixel
    (0, 0) should light at that edge; if not, #pinYOffset goes to -29 and the
    lower brace, same width, takes the pins.
    Variable descriptions in Onshape updated to match, and the inserts recorded
    as M3.
2026-10-11 P2 rear: flatbed scan cross-checks the caliper table
    600 dpi scan of the Waveshare P2 64x64-B back plus a second hand-measured
    sheet. Insert centroids, de-skewed and taken from the pattern centre, land
    within 0.3 mm of the 10-03 numbers and are left-right symmetric to 0.1 mm, so
    the model variables stay. Pin tip faces scan at 2.2-2.3 mm against 2.87 by
    calipers and "2 mm" on the sheet: the shank diameter is the open item.
2026-10-11 P2 rear: compare from the rear edges, not the panel centre
    The panel has no centre feature to measure from; its rear outer edges are the
    datum. The 10-03 calipers were already edge-referenced, so the 10-11 sheet now
    compares against them directly, and the scan contributes only hole-to-hole
    spacings, which need no datum. On every spacing where the sheets differ
    (7 vs 6.5 right inset, 20 vs 19.5 row, pins in line vs 1.25 inboard, 34 vs
    34.5 down) the scan sides with 10-03.
    Pins re-measured at 2.83-2.87 on the shank: a nominal 3 mm hole, which is what
    the brace already has. The 2.2-2.3 the scan saw is the chamfered tip.
2026-10-12 P2 rear: edge-referenced rescan agrees with the 10-03 calipers
    Rescanned with paper over the panel so the rim reads dark on light. The panel
    rests on its pins, so only the top and left rear edges are on the glass; those
    fit to ~20 um and give side inserts 19.47 down / 6.52 in, pins 34.58 down /
    7.70 in, mid insert 6.70 down -- all within 0.2 mm of 10-03. The 7 mm right
    inset and 20 / 34 on the 10-11 sheet are not borne out. Right and bottom edges
    are blurred and only reached via the 127 back.
2026-10-12 P2 rear: rule-calibrated, 90-degree rescans pin down the scale
    A steel rule on the glass puts the scanner's y axis at +0.05 % (130 ticks over
    134 mm). Turning the panel 90 degrees ran its top-to-bottom spacings along that
    calibrated axis: both scanner axes agree to 0.1-0.25 %. So the 113.3 mm
    mid-to-mid insert spacing is real, not scanner scale. The mid-edge pair sits at
    (0, +-56.65), 6.7 below the top edge, against the calipers' 114 / 6.5. That pair
    is left free in the model, so nothing moves.
    Everything the braces use holds to 0.2 mm: side inserts 19.45 down / 6.49 in,
    pins 34.5 down / 7.6 in. The 0.35 mm out-of-square seen earlier flipped sign
    after the rotation; it was edge-fit noise.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
2026-10-12 Model the P2 mid-edge inserts at (0, +-56.65)
    #midPostYOffset 57 -> 56.65 in the Onshape Variable Studio, from the
    rule-calibrated scans: 113.26 / 113.31 mm apart along both scanner axes. The
    other 110 variables are unchanged, all three Part Studios regenerate clean,
    and the proxy studio evaluates the variable at 56.65. Nothing screws into
    this pair, so only the panel proxy moves.
2026-10-12 Desktop: 2 x 2 P2 array on a Colorlight 5A-75B + Pi Zero 2 W
    The Matrix Portal S3 and the 2 x 1 landscape layout are replaced. The P2
    panels are small, so four of them are the instrument: 128 x 128 px, 256 mm
    square, in a 297 x 373 x 60 box that stands on its bottom wall.
    Model (pushed; Onshape version "Before 2x2 Colorlight" holds the old one):
    - panelProxy, bayObstructions, enclosureShell: panel count -> cols x rows.
    One brace per insert row at rowCentre +/- 44; braces that touch merge, so
    the 2 x 2 gets three: [88,128], [-40,40], [-128,-88]. Every pin and slot
    point was probed open, the brace body solid between.
    - Matrix Portal block -> Colorlight (placeholder outline), Pi Zero 2 W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
2026-10-12 Measured panel connectors, Colorlight and Pi Zero models, M3 board bosses
    Box: side margin 20 -> 18 mm, so it is 293 wide and the outer bezel has
    ~6 mm a side across the xTool P2's 305 mm axis and 12"-wide stock. The
    laser-cut doc's "30 W" assumption is corrected to the 55 W P2, with a
    12 x 24 buying note and nesting.
    Panel connectors, off the rule-calibrated scan: HUB75 IN/OUT are vertical
    2x8 shrouds at (+-35.9, +5.6), 8.8 x 29.5; the 5 V input a 4-pin VH-style
    header at (-10.1, +5.3). The old model had horizontal headers at +-20 and a
    70 mm keep-out that missed the real shrouds. Keep-outs are now per
    connector and clear the braces by 2.55 mm (HUB75) / 8.85 mm (5 V).
    Colorlight 5A-75B, o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
2026-10-12 Boards hang off the middle brace; measured heights; PSU proxy from the STEP
    The back cover now carries nothing and has no cable to it. The Colorlight,
    Pi Zero 2 W and gigabit adapter hang off the rear face of the middle panel
    brace, component side facing back, so they are in reach once the cover is
    off. The card turns horizontal (RJ45 toward the Pi) so its two rows of four
    HUB75 headers face the two panel rows, offset to (30, 5.5) for 29 mm of
    patch-cable room. The M3 nut-trap bosses move from the cover to the brace,
    which grows from [-40, 40] to [-40, 51.4] to carry them, 2.5 mm short of the
    top row's HUB75 keep-outs; brace clearance holes take the screw tips.
    Measured: plugged HUB75 cable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
2026-10-12 Electronics tray, captive-nut doubled brace, real LRS-50-5 in the studio
    Boards no longer hang off the brace on glued bosses, which covered panel
    screws, left the RJ45 29 mm and needed glue. They mount on a removable ply
    tray, fitted on the bench with M3 x 14, two ply spacer rings and a plain
    nut - no glue, both faces in reach. The tray screws to the back of the
    middle brace with 4 x M3 x 14 into captive nuts: the middle brace is now two
    sheets, the front one with hex pockets closed by the panel back and the
    rear sheet, clamped together by the panel screws. Assembly: nuts -> panels
    -> tray (pre-loaded) -> cover; the tray is the only thing over the panel
    screws and comes out with four screws.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
2026-10-12 Every nut in a clearance/hex/clearance sandwich; PSU capacitors in place
    Nuts: the tray nuts sat in a single pocket closed only by the panel back,
    and the board nuts were loose. Now every nut joint is three layers, as the
    cover rails already were:
    - tray -> brace: the middle brace is three sheets (clearance against the
    panels, hex, clearance), tenoned, clamped by the panel screws; M3 x 16.
    - board -> tray: the tray is two sheets (clearance front, hex rear) and a
    3 mm ring under each board is the layer the nut pulls against; M3 x 8.
    No glue anywhere. Rings: 1 tray-to-brace (8 mm OD), 1 per board hole (7 mm,
    about the Pi Zero's pad keep-out). Depths unchanged: card PCB at -35.5,
    terminal b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
2026-10-12 Laser cut files: DXF per part, exported from the model
    hardware/cad/tools/export_dxf.py pulls each sheet part's cut face from the
    Onshape enclosure studio (FeatureScript over REST), projects it to the
    part's plane, and writes DXF R12 in mm with true LINE/ARC/CIRCLE on layer
    CUT. Identical parts are grouped (rail pairs, spacer rings, the middle
    brace's front and rear sheets), with quantities in MANIFEST.md and a
    preview.png. 33 parts, 19 files, every outline a closed loop.
    Kerf (0.2) and thickness (3.0) are baked in from the Variable Studio and are
    still placeholders: measure the sheet, cut the test comb, set them, re-run.
2026-10-18 Test cuts: validate every critical dimension on one 12 x 12" sheet
    hardware/cad/tools/test_cuts.py generates ten small pieces from the live
    Variable Studio and enclosure.fs's board data, each kerf-compensated by the
    model's own rules, values engraved (layer SCORE) beside the sweeps:
    1 finger-joint pairs at kerf 0 - 0.3 -> #kerf, #thickness
    2 through-tenon / mortise at the same -> #kerf
    3 hex pocket sweep, 5.1 - 5.6 AF -> #nutAcrossFlats
    4 the clearance/hex/clearance sandwich -> captive-nut behaviour
    5 hole gauge: M3 clearance, reg. pin, EC11 bore, PSU screw
    6 panel fit jig: pins, side inserts, mid insert on a real panel back
    7 Colorlight template: the scanned hole pa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
2026-10-18 Sheet thickness measured: #thickness 3.18 (range 3.05 - 3.18)
    Set to the maximum so every mortise and slot takes the thickest sheet;
    fingers on thinner sheets finish up to 0.13 proud and sand flush. The press
    fit is still set by #kerf, which waits on the test comb.
    Clearances re-checked at 3.18: adapter 3.96 from the back cover, boards 4.48
    from the panel keep-outs, tray 1.95 from the 5 V plugs, braces 2.55, PSU 2.04
    from the stiffener. Box depth 60.72. Box DXFs and test cuts re-exported; all
    loops closed. Dead LRS_* constants and the unused boardBox helper removed.
2026-10-18 Test cuts: every path is safe to cut
    The laser software cuts every path regardless of layer, so the scored
    reference geometry was being cut too - and the Colorlight's RJ45/HUB75
    profiles, the Pi's connector outlines and the IEC flange outline cut across
    the very outlines they annotated. Gone. What is left is outlines, holes and
    the engraved numbers:
    - board templates: footprint + 4 mm, mounting holes, number. The holes alone
    locate the board.
    - IEC coupon: cutout and flange screw holes only.
    - PSU strip: the terminal-end mark is a small cut-out triangle, not a line
    that would nearly sever the strip.
    - panel jig: its marker is a cut-out triangle pointing at the pin edge
    (it pointed awa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
2026-10-18 Fit-test results into the model; knob pockets; DXFs re-exported
    From the test sheet (2026-10-18):
    - #kerf 0.15: tight but hand-placeable (0.2 needs a mallet); right for
    glued joints with dozens of fingers per edge.
    - hex pockets: drawn 5.35 (between 5.3 tight and 5.4 gentle) - falls out of
    #nutAcrossFlats 5.5 at the new kerf, unchanged.
    - #screwDia 3.05: M3 passes freely at a drawn 2.9.
    - #pinHoleDia 2.95: registration pin ideal at a drawn 2.8.
    - #psuHoleDia 4.45, #iecScrewDia 3.35: both perfect - drawn sizes kept.
    - #iecCutW/H 47.1 x 27.6: the coupon was a bit tight, opened 0.4 each way.
    - EC11: 5.5 mm of thread, 2.3 mm jam nut - one sheet only. Every bezel
    lamination behind the outer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
2026-10-18 Knob pockets 35 mm square for the 4991 encoder breakout
    The encoder clamps only the outer bezel sheet; the inner sheet's pocket now clears the Adafruit 4991 QT breakout and its STEMMA QT plugs (35 mm square), not just the 15 mm encoder body. 10 mm web between pockets at 45 mm pitch; box clear ~41 mm behind the bezel there. bezel-inner.dxf re-exported; docs updated.
2026-10-18 Bezel is one sheet
    The EC11 clamps only one 3.18 mm sheet, Baltic birch needs no cross-grain doubler, and without glue nothing held the inner lamination in place. #frontLayers = 1; the single sheet is named "Bezel" (bezel.dxf, byte-identical to the old bezel-outer.dxf); bezel-inner.dxf is gone and the dead assembly instance removed. extDepth no longer double-counts the bezel. Docs updated, including a three-sheet 12 x 24 nest (was four).
2026-10-18 Cut sheets: the whole box nested on three 12 x 24 sheets for the P2
    nest_sheets.py lays the part DXFs onto three sheets within the P2's 600 x 305 cut area (3 mm margins and gaps), checks every manifest part is placed once per qty, and writes sheet-N.dxf (cut paths only), labelled PNGs and a README cut list. Spare spacer rings included. export_dxf.py now draws the box skin (bezel, walls, back cover) as seen from outside, so the face up on the bed is the visible face; back cover, top and right walls re-exported mirrored (same parts, other face out). MANIFEST text no longer calls thickness/kerf placeholders.
2026-10-21 Rev 2: glued doublers on the bezel and every wall; PSU in the bezel corner
    Rev 1 (tag rev-1, Onshape version 'Rev 1 - as built') flexed when the knobs were pushed and the PSU floated on one wall. Bezel back to two sheets (#frontLayers 2), the inner one pocketed 35 mm at the knobs. New #wallLayers: a glued doubler inside each wall, from the bezel's rear face to 0.5 mm short of rail C; mortises, PSU holes and IEC cutout pass through. PSU sits on the bottom doubler against the bezel (#psuStandoff 0, #psuZFront -6.36); #psuRailClear 11.64 keeps depth at 60.72. Tray narrowed 6.36; Pi and adapter moved 3.5 mm right. Four cut sheets. hardware/REVISIONS.md records both revisions and the hardware cha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
2026-10-21 Rev 2: knob ribs and a stiffener shelf behind the knob band
    The knob band's top edge (the bottom of the display aperture) was unsupported. The stiffener web now runs forward to the inner bezel over the knob cluster (Stiffener shelf), and two ribs at the knob-column boundaries (x -95, -50) run from the bottom doubler to the shelf, so each knob sits in a cell supported on four sides. Ribs locate with hidden tabs into the inner bezel only and are glued top and bottom; rib 1 and the shelf have cable holes for the STEMMA chain. The ribs nest inside the inner bezel's aperture on sheet 4 (inner-first cutting); nest_sheets.py checks in-hole placement.
2026-10-21 Rev 2: Raspberry Pi 5 on the electronics tray, replacing the Pi Zero 2 W + USB Ethernet adapter
    Pi 5 data from the official drawing (85 x 56, 58 x 49 holes, M2.5); ports and Active Cooler as envelopes. It stands on end at the tray's left (piX -108, piY 0): lying flat its Ethernet jack would face the Colorlight's ~30 mm away. Jack points down past the tray edge; USB-C faces the cable gap; the USB stack ends 3.2 mm short of the back cover. Tray board sites carry their own fastener sizes: M2.5 clearance and nut pockets for the Pi (new #piScrewDia, #piNutAF), M3 for the card. Adapter envelope, strap slots and #nic* removed. Colorlight and Pi spacer rings are now separate DXFs. Test piece 8 is a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
2026-10-21 Rev 2: back-cover vent grilles and etched circuit-board art
    Vents: three fields of 3 mm obround slots in the back cover (over the PSU, over the Pi 5, and across the top), clear of the rails and their screws; rows over 60 mm split with 6 mm bridges. New #ventSlotW/#ventPitch/#ventMaxLen/#ventBridge. Art: art.py generates a seeded PCB-trace pattern (45/90 traces, chips with pin rows, vias, knob dials with ticks) on the outer faces of the bezel, side walls, top wall and back cover, kept 1.5 mm+ from every cut and off the finger joints. nest_sheets.py carries each part's art through its rotation and placement into sheet-N.svg (cut red, score blue, engrave black); DXFs stay cut-only.
2026-10-21 Rev 2: vents move to the bottom and sides; etched art shown in Onshape as decals
    The back cover is plain again (the box sometimes stands against a wall). Intake: 3 mm slots through the bottom wall + doubler, between the knob ribs and right of the PSU. Exhaust: slots high on both side walls + doublers. #ventMaxLen/#ventBridge removed. Art: art.py also renders a transparent PNG per etched part over its exact DXF frame; decals.py uploads them as image elements and rewrites the ART IMPORTS block; the Enclosure shell lays each on its part's outer face with the std decal functions (createPlanarDecal/associateDecalAttribute), framed by a new 'Art origin' mate connector per part. A decal failure is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
2026-10-22 Etched art v2: dense, detailed circuit board on a 1.27 mm grid; real knob dials
    art.py rewritten: QFP/BGA/SOIC chips with fan-out, passives, headers, crystals, test points, fiducials, spiral inductors, Hilbert meanders, length-matched serpentines, wide power traces (outlined), parallel buses, silkscreen designators in a new single-stroke font (artfont.py), and leftover space poured with hatch, cross-hatch, topographic contours or stipple, or left empty. Hidden: a data matrix encoding a message, a space invader, a Lissajous figure, tiny words. Knobs get 0-10 dials over 270 degrees with fine ticks, numerals and names. All marks are Score (dots as concentric circles) so nothing rasters; SVGs ch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
2026-10-22 Etched art: unlabelled knob dials; real scannable QR codes instead of the decorative matrix
    Dials keep their rings, fine ticks and gauge arc but lose the numerals and names. The fake data matrix (finder pattern, no encoding) is replaced by a real QR code per part (segno, ECC M, 0.8 mm modules, 1.0 mm on the back cover, 4-module quiet zone kept clear), dark modules filled with score lines 0.12 mm apart so they burn solid. art.py renders each code back from the score lines drawn and decodes it with zxing-cpp when installed: all five decode. Sheets and decals regenerated.
2026-10-22 Knob light slits: a ring of 36 radial slits round each knob for the 4991 NeoPixel
    Through the outer bezel sheet only (the inner is pocketed there): 0.7 mm wide, r 13-16.5 mm, a full ring so it works wherever the LED sits and however the board is turned. Etched dial moved outside them (rings r 18.6/19.4). Model change in enclosure.fs (constants KNOB_SLITS etc.bezel-outer.dxf patched to match by a script mirroring the FeatureScript; push + export_dxf + decals.py pending, see REVISIONS Rev 2.1.
2026-10-23 Knob bridge: FeatherS3 streams the 4991 encoders to a host as JSON lines
    Scans the STEMMA QT bus, takes every 4991 at 0x36-0x3D in address order,
    and reports encoder/button changes plus a 2 s health heartbeat over USB
    serial. The host can rescan and set each knob's NeoPixel. Bench-verified:
    all four knobs found at 0x37-0x3A.
2026-10-23 Colorlight: Glasgow JTAG flash-dump script and v8.2 bring-up notes
    ecp5_flash_dump.py reads the 5A-75B's config flash through LSC_PROG_SPI
    using the jtag-probe applet's bulk shifts, at ~60 KiB/s. The README records
    the Glasgow wiring and which bridges work: XVC deadlocks with openFPGALoader,
    and remote-bitbang runs at ~3 KiB/s. The stock image was backed up with this
    script, outside the repo.
2026-10-23 Colorlight: SVF player for SRAM loads; record the TDI-TDO wiring fault
    svf_play.py plays ecppack SVFs on the jtag-probe interface, keeping
    Pause-DR between burst chunks and checking every TDO. Loading receiver75
    reached the end but failed with a CRC error: on the bench wiring, TDO
    reads corrupt while TDI is low, so bits are being corrupted between the
    two lines. Documented in the README pending a hardware check.
2026-10-23 Colorlight: receiver75 drives all four P2 panels; slot-ID test pattern
    receiver75 loaded into SRAM and answered ARP at 192.168.75.39. A dim solid
    frame lit all four panels evenly with no flicker. r75_slot_ids.py draws
    each slot's number, to map slots to positions.
2026-10-23 Colorlight: 128x128 frame sender with the bench slot map; doc the receiver75 path
    Each connector Jn drives receiver75 slot 2n-1. Upper-left J5 is slot 9,
    upper-right J8 is 15, lower-left J4 is 7, lower-right J1 is 1, all upright.
    r75_frame.py maps a 128x128 frame onto them and sends a seam test.
    driver-colorlight.md now records the actual ports and the LEDVision-free
    path.
2026-10-23 Colorlight: seam test confirms the 2x2 slot map
2026-10-23 Colorlight: knobs drive patterns on the 2x2
    knob_renderer.py renders plasma, tunnel and ripples at ~60 fps,
    double-buffered through receiver75's two banks. It applies gamma and a
    per-frame current cap (1.2 A a panel, 4 A in total) and maps knobs to hue,
    speed, scale and brightness; the presses switch pattern, freeze, reset and
    blackout. knob_link.py joins the FeatherS3 bridge on one host to the
    renderer on the host wired to the card, over SSH. r75_frame.py gains
    banks, enable and show_bank.
2026-10-23 Colorlight: JTAG flash writer; receiver75 now boots from flash
    ecp5_flash_write.py writes an image over LSC_PROG_SPI. It retries the
    pass-through entry (the first of a session sometimes misses on the bench
    wiring) and clears the stock BP2..0 protection with a one-byte WRSR (this
    GD25Q32C ignores the two-byte form). It erases, programs and verifies every
    byte, then restores the protection. receiver75 was written at offset 0
    (663,499 bytes, verify OK) and comes up at 192.168.75.39 after a power cycle.
2026-10-23 knob_renderer: re-enable receiver75 every second; show blackout/freeze in the log
    receiver75 boots with output disabled, so after a card power cycle the
    display stayed dark until the renderer was restarted.
2026-10-23 Pi Zero W controller appliance, I2C knobs, and wiring plan
    firmware/pi-controller holds the card layout and provision_card.py, which
    turns a Raspberry Pi OS Lite (trixie, armhf) card into the controller. It
    uses userconf.txt to rename pi to jof, cloud-init for hostname, Wi-Fi and
    numpy, a NetworkManager profile giving any wired NIC 192.168.75.1/24, I2C
    on, Bluetooth off, and patternflow.service. Secrets come from files at
    provisioning time.
    knob_renderer.py gains --knobs i2c (seesaw.py, a stdlib-only driver for
    the 4991 encoders over i2c-dev, with a bus lock and glitch filter), --res
    64/32 upscaling for the Zero W, --fps, and frame sends that ride out a
    missing link. It also blanks the disp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
2026-10-23 Boot splash on the panels: Pi steps it on from initramfs and systemd
    The card's BIOS (receiver75 branch boot-splash) draws a spinner and a
    five-step bar from power-on. pf-splash moves the bar on by writing the
    card's ctrl_scratch CSR, sent as a raw Ethernet frame to the card's MAC,
    so it needs no IP address, only link:
    2 initramfs, in the background
    3 early systemd (sysinit, after udevadm settle)
    4 NetworkManager up
    5 renderer starting
    patternflood.service's ExecStopPost puts the spinner back while the
    renderer is stopped or restarting.
    pf-splash is freestanding C with raw syscalls (Ubuntu's armhf libc is
    ARMv7; the Zero is ARMv6). It finds the NIC with ioctls rather than
    /sys, be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
2026-10-23 Pi: passwordless sudo, serial console, and a login header
    Trixie ships no pi-nopasswd sudoers rule for userconf.txt's rename to
    carry over, so jof got no passwordless sudo; add one in sudoers.d (0440).
    enable_uart=1 puts the console on GPIO14/15 for a Glasgow, to see why the
    Pi resets when the USB Ethernet adapter is plugged in.
    The login header shows a wordmark, then whether the renderer runs, whether
    the card's link is up, and any under-voltage since boot.
2026-10-23 Record why USB Ethernet fails on the Pi Zero's bare port
    Two RTL8153 adapters never worked on the Zero's OTG port. They either
    never connected or fell back to full speed with error -71. Meanwhile a
    USB stick ran at high speed through the same dongle and extension, and
    the header held 5.045 V. The adapters drew 0.64-0.90 A on the Pi
    against 0.41 A on a PC, and the Anker overheated and no longer
    enumerates anywhere.
    The wiring doc records the measurements and the serial console. It
    also corrects the adapter's power budget and describes the fix to try:
    a power-injected extension that feeds the adapter from the PSU and
    leaves the Zero's port carrying data only. The Colorlight README now
    says th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
2026-10-23 Wiring doc: a Pi Zero 2 W fails the same way; suspect the OTG dongle first
2026-10-24 Demos: one runtime for the bench and the Pi 5, and eight interactive demos
    ash renders and reads the FeatherS3 knobs. Durian is a dumb pipe: run.py
    sends r75_pipe.py over the ssh command line, and it turns stdin records into
    UDP for the card. The same demos run on a Pi 5 with --knobs i2c --out udp,
    or offline into a GIF preview.
    Classic ports the three knob_renderer patterns. Etch, Squash, Cycles, Sand,
    Harmono, Rewind and Reaction each test one interaction hypothesis, listed
    in demos/README.md.
2026-10-24 Demos README: durian's card link is a NetworkManager profile now
    An address added by hand was wiped by NetworkManager's DHCP timeout, and
    frames then went silently over Wi-Fi while the card kept its spinner.
2026-10-24 Classic: a visible step per detent, and a gauge for each turn
    The knob_renderer step sizes took several detents to show any change.
    Speed, scale and level now change by x1.15 per detent, and hue by 1/24 of the
    wheel. A bar along the bottom edge shows the parameter that was turned.
2026-10-24 Knobs: clockwise is positive; the 4991 counts down clockwise
    Every knob felt backwards on the bench. Flip the sign where events enter
    (serial bridge and I2C, and knob_renderer's handle()), and undo the
    menu-only flip, which was this same bug.
2026-10-24 Demos: run all 34 upstream Patternflow presets natively, and five new demos
    upstream_host/build.py compiles upstream's preset headers, unchanged, against
    host stand-ins for the Arduino and panel headers, into one shared library
    with a C API. pfd/upstream.py wraps each preset as a demo through ctypes.
    The presets are read from the gitignored upstream clone and not committed.
    Midsummer Sea and Firefly Hollow are portrait: turned upright. Breakout
    Arcade runs at 128x64, turned and centred. The shim's min/max returned a
    dangling reference, which crashed 0521/0522 with SIGFPE; they now return by
    value.
    New demos: Rotor (Asteroids, absolute heading), Echo (Simon on the knob
    lights), Rocket (hold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
2026-10-24 Demos: port upstream's 14 web-only patterns, and five demos after Lee's ideas
    The 14 patterns upstream only had as JavaScript are ported to C++ headers in
    upstream_host/web_ports/, following upstream's cppPrompt.ts and the knob
    conventions of its existing ports. tools/compare.py runs the JS in Node beside
    the C++ and compares frames: all 14 are within 1.9/255 mean and 1% of pixels,
    and six match exactly. They are CC BY-SA 4.0, as their sources. 0517 and 0519-2
    keep the JS's sine hash and double maths for fidelity, since these run on x86
    and the Pi 5, not the ESP32.
    build.py builds both panel sizes, sorts presets by name so the ports
    interleave by date, and the wrapper finds the 128x64 prese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
2026-10-24 Resort: generated city-pop scenery after Hiroshi Nagai, steered by the knobs
    Seeded scenes (pool, beach or coast drive) in flat, hard-edged colour:
    cobalt-to-pale skies, flat-bottomed cumulus, turquoise pools with white
    coping and caustics, palms, modernist blocks with blue shadow faces, a
    convertible. k0 runs the light from noon through golden hour and banded
    sunsets to night (lit windows, a glowing pool, headlights). k1 browses
    scenes, k2 sets the horizon and mirrors, k3 picks a palette or an
    album-cover frame with a made-up title.
    draw.poly fills polygons. Static layers are cached, and palms redraw at
    about 15 Hz: a typical frame is 0.45 ms on ash.
2026-10-24 Resort: an endless coast to pan along, continuous colour stories, fixes
    k1 now pans a coastline generated lot by lot: pools, sun decks, beach and
    a coast road, meeting along diagonal curbs, with the shore eased between
    lots and parallax for clouds and stars. Click k1 to cruise.
    k3 is a continuous colour story (cobalt, lagoon, vivid, violet): a hue
    turn in YIQ plus saturation on the sky, sea, sun and pools. The stepped
    palettes are gone.
    The coupe now faces the way it drives, with visible wheels (draw.disc
    gains an 'over' mode). Cloud sprites are wide enough for their end puffs.
    draw.poly and draw.disc clip to the image they draw into, not the panel.
    Palms are cached as part maps, recolour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
2026-10-24 Resort: palms sway through seven drawn poses, not a row shear
    The shear rounded each row's shift separately, so rows crossed the rounding
    threshold one at a time and the tree zipped rather than bent. Each palm is
    now drawn in seven sway poses (trunk lean, crown and fronds together,
    fronds flattening downwind), made on demand and cached, and each frame
    picks the pose for a slow sway plus a lighter gust.
2026-10-24 Audio: hear what ash plays; beat, bar and phrase tracking; five visualizers
    pfd/audio.py captures the default output's monitor (or ALSA, or a file),
    holds it back by --audio-delay (0.2 s for Bluetooth) so beats land when
    heard, and analyses it: level, 24 bands, onsets, tempo by autocorrelation
    with bar and two-bar repeats (rejects the 3:2 breakbeat alias), a beat clock
    aligned to decay-weighted kick onsets, downbeats, predicted 8-bar phrases,
    drops and builds. About 1% of a core.
    tools/audio_test.py scores it on a generated track with known truth:
    tempo within 0.3%, beat F 0.91-0.94, downbeats 0.77-0.94.
    New demos: Tempo (the tracker shown, with tap tempo, mark the one, phrase
    shift and A/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
2026-10-24 Shelves in the menu; audio versions of our demos; Winamp-inspired Milk and Superscope
    The menu now has shelves (Play, Audio, Patternflow): k1 moves between them,
    k0 along one. The audio-knobs toggle shows on the Patternflow shelf only.
    New on the Audio shelf: Milk (MilkDrop-style feedback warp under the
    waveform, presets blended at phrases) and Superscope (AVS-style point
    shapes: spectrum ring, waveform tunnel, torus knot, spectrum sphere), and
    Prism, Rain, Spores, Lissajous and Night Drive: Kaleido, Droplet, Reaction,
    Harmono and Resort played by the music, keeping their own knobs.
    Prism turns its barrel in eased nudges per bar: turning it steadily
    outran the beads, which lagged gravity o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
2026-10-24 Lower latency, dancing palms
    Output defaults to auto: straight UDP when the card answers on this host's
    own Ethernet (ash now also holds 192.168.75.2 on its wired LAN), else the
    durian pipe. Wiring the card into the LAN takes Wi-Fi out of the loop.
    The Bluetooth hold-back drops to 0.15 s: A2DP trails its monitor by ~0.2 s
    and the panel shows a frame ~30-50 ms after the analysis sees it.
    Night Drive's palms dance: a swing to one side on one beat and back on the
    next, reaching the end of each swing on the beat, wider when it's loud,
    with a kick accent, through eleven poses that lean further than Resort's.
2026-10-24 Milk becomes a MilkDrop engine; four more families of presets
    The engine resamples the last frame through a per-pixel motion field, as
    MilkDrop does: zoom (bass, and radius for tunnels), turn (mids, and radius
    for whirlpools), warp (treble), a wandering centre, drift, stretch and
    wrap. On top: seven wave types and shapes, solid or textured with the
    screen. On the way out: video echo, kaleidoscope folds, colour maps and a
    drop's inversion.
    New demos, each a family of presets blended at phrases: Milk Tunnel,
    Milk Flame, Milk Mirror and Milk Echo. 1.3-2.8 ms a frame on ash.
2026-10-24 Milk: a rhythm layer locked to beats, bars and phrases
    The presets followed loudness only, which reads as busy rather than in time.
    Now every preset also gets: a zoom punch decaying through each beat, a wave
    swelling on the kick, a hue step per beat, a warp wobble in beat time, a turn
    that swings one way per bar and back the next, a ring stamped on each
    downbeat for the field to carry off, zoom and warp ramping across the
    eight-bar phrase, and a quick half-bar cut with a flash at the boundary.
    On a drum & bass set, frame-to-frame motion roughly doubles, the first
    quarter of each beat moves 1.8-1.9x the rest, and downbeats now stand out
    (~2x other beats, from ~1x).
2026-10-24 Impacts: big changes made bright, whatever their loudness
    A warm bass drop that isn't loud barely registered: the drop rule wanted
    6x the low end and a louder bar, and the visuals follow normalised levels.
    The analyzer now scores impact: the last ~0.4 s against the strongest and
    most similar moments of the ~6 s before (so a bass arrival counts, and a
    stab that recurs every two bars doesn't), once per change, with a strength.
    The runtime flares the Audio shelf's visualizers on it: lit parts blaze
    towards white, scaled by strength, fading over about a second. Milk
    punches and fires a white ring (its old drop inversion and wash, which
    whited the frame out, are gone); Pulse bursts; Spectrum sho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
2026-10-24 Patternflow shelf: five originals in our own style, among Lee's presets
    Bit Tunnel (XOR texture tunnel, dithered), Obra (raymarched solids printed in
    inks through dither and halftone screens), Riso (three churning halftone plates),
    Pixel Sort (a landscape melted by sorting bright runs) and Strange (a Clifford
    attractor's glow the knobs bend). Each follows the preset of Lee's it riffs on.
    pfd/ink.py holds the screens and inks; pfd/demos/original.py the shelf's audio
    knobs, with beats, bars and phrases driving each pattern's changes.
2026-10-24 Obra: half resolution only past 12 ms a frame, after warm-up (the audio thread inflates ash's timings)
2026-10-24 Patternflow shelf: three more dithered originals, and a cross-hatch screen
    Moon (a cratered moon, an Earth or a ringed giant, lit through its phases),
    Smoke (incense on a curl-noise flow that grows turbulent with height) and Sea
    (raycast swell with Fresnel sky and a glittering moon path). ink.py gains a
    pixel-exact cross-hatch screen, which every dithered original offers, and a
    silver palette.
2026-10-24 Patternflow shelf: Caustics and Galaxy; an Inked base and three palettes
    Caustics: light through moving water, splatted onto a tiled pool floor. Galaxy:
    a density-wave spiral (stars flowing through arms that persist), with dust lanes
    and a bar. Inked gathers the screen and ink knobs the dithered originals share.
2026-10-24 Patternflow shelf: Valley, a dithered flight over mountains at dawn, dusk or night
2026-10-24 Patternflow shelf: Lava, a lava lamp of compact metaballs heated at the bulb and cooled at the cap
2026-10-24 Patternflow shelf: Tesla, a plasma globe whose filaments leap to your finger
2026-10-24 Patternflow shelf: Window, rain on glass over a city's bokeh, each drop a tiny inverted lens
2026-10-24 Patternflow shelf: Aurora, rayed curtains over mountains and a mirroring lake
2026-10-24 Patternflow shelf: Gears, a meshing clockwork train in brushed brass, engraved
2026-10-24 README: Fireworks, Gears, Pendulums, Spiro and Orrery; Gears: k1 anticlockwise no longer crashes
2026-10-24 Patternflow shelf: Neon, a buzzing sign on bricks, each colour its own dithered plate
2026-10-25 Patternflow shelf: six more full-colour originals
    Moiré (gratings turning into sweeping fringes), Copper (Amiga bars and a sine
    scroller), Streams (particles combing a curl-noise flow), Girih (an eight-point
    star zellij from a sixteenth-cell fold), Marbling (exact ink drops and combs,
    traced back per pixel) and Dial (rings that turn and line up like a lock).
2026-10-25 Girih morphs between star tilings; Marbling runs smooth
    Girih: {n/k} stars of 8, 16, 4, 6, 12 and 10 points on square or hex lattices,
    k (sharpness) continuous, a change of star blending the outlines (dissolving
    across a change of lattice); it moves on by itself every 12 s.
    Marbling: drops swell into place instead of appearing whole, retired operations
    are baked into a stored tray instead of popping out, and each pixel is traced at
    four points for antialiased edges (colours from a lookup table to keep it at
    about 4 ms).
2026-10-25 Three push buttons on the left wall; maker credits and a patternflow.work QR on the back cover
    Buttons: 12 mm waterproof momentaries (the VanMoof S3 boost button, Amazon
    B07F24Y1TB), a vertical row high on the left wall at 24 mm pitch. Keyed holes
    (12.2 with flats 11.2 apart) through the wall; the doubler is notched away
    behind the row so each nut clamps the outer sheet alone, the thread being only
    ~6.4 mm. The left wall's exhaust moves down under the buttons (4 slots; the
    right wall keeps 14). Constants BTN_* in enclosure.fs, a mate connector per
    button. Test cut 11 sweeps the key clearance.
    Art: a framed credits plate on the back cover (MADE BY JOF / JOF@THEJOF.COM /
    INSPIRED BY PATTERNFL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
2026-10-25 CAD tools share one Onshape transport, onshape_http.py
    push.py, export_dxf.py and decals.py send their calls through one module,
    and a 401 stops a run with a hint.
2026-10-25 Rev 2.2 synced to Onshape: buttons, Rev 2.1 slits and all five decals pushed
    export_dxf.py now reproduces every DXF;
    the three that had been patched by script (bezel-outer, wall-left and its
    doubler) were geometrically identical and are replaced by the real export.
    decals.py re-uploaded the art images and re-pinned their imports; every decal
    attaches. Test cut 11 (push-button key sweep) generated onto the test sheet.
2026-10-25 Etch text in IBM Plex Mono (filled) and Hershey Sans 1-stroke below 1.3 mm
    artfont.py keeps its interface but sets text >= 1.3 mm in IBM Plex Mono Medium, outlines flattened with fontTools and filled solid with score lines 0.12 apart (inset half a beam; thin strokes filled uninset), and smaller text (designators, chip names, hidden words) in the single-stroke Hershey Sans 1, like real PCB silkscreen. Fonts vendored in tools/fonts with their licences. The credits plate is now mixed case; the title block keeps pours out of itself. All art, sheets and decals regenerated: checks clean, QRs decode, cut paths unchanged.
2026-10-25 Etch font: original grid font under 1.3 mm, JetBrains Mono (filled) above
    Replaces the Plex/Hershey split. Small text (designators, chip names, hidden words) is back in the 4 x 6 single-stroke grid font, unchanged; the title block and credits plate are JetBrains Mono Medium, filled solid with 0.12 mm score lines under the nonzero fill rule (the variable font's 8 is two self-intersecting contours). Designators now keep off the plates. Only the back cover's art differs from rev-2.2; art, sheets and decals regenerated, checks clean, QRs decode, decals attach.
2026-10-25 Buttons to the top wall's left end; left wall restored; a shelf wire passthrough over each knob column
    The three push buttons now sit in a row along the top wall's left end (x -128.1/-104.1/-80.1, 24 mm pitch, z -32.6), the top doubler notched out of its rear left corner behind them. The left wall and its doubler are back to their 14 exhaust slots and plain doubler, byte-identical to 1ec6424. The stiffener shelf gets a 20 x 9 mm wire passthrough over every knob column, not just the right one.
2026-10-25 REVISIONS: rev-2.2 includes the top-wall buttons; the Onshape version predates them
2026-10-25 Rev 2.3: back cover doubler with board reliefs, French cleat holes, art meander variety, paper knob diffusers
2026-10-25 Back cover doubler: windows over the Colorlight's 5 V power header and JTAG header (new in the model)
2026-10-25 Bottom wall: Ø8 recesses for the PSU screw heads, clamping on the doubler; M3 x 8
2026-10-25 PSU head recesses sized for the screws on hand (5.5 x 3.2): Ø7.5, no washer
2026-10-25 #psuHoleDia 4.45 -> 4.1: ~0.8 mm of doubler under the recessed screw heads, +-0.48 of slack; test cuts follow
2026-10-25 Test cuts since rev 1 (test_cuts_delta.py): knob stack, Pi 5, buttons, PSU recess pair, new holes, etch sampler; XCS layer notes; Rev 2.4 for cutting
2026-10-25 Sheets: separate -cut/-score SVGs with matching registration marks, for importing cuts and art separately
2026-10-26 Push-button hole shaped to the lip (Ø13, one flat at 12.88), BTN_CLEAR 0.3; test piece 11 sweeps it 0.1-0.5; test-cut results recorded
2026-10-26 BTN_CLEAR 0.2 from the lip sweep; PSU test cut passes; Rev 2.5 for cutting
2026-10-26 Sheets re-packed: 6 mm from the ends, 5.9 from the long edges, 4 mm gaps; three strips to sheet 5
2026-10-26 Sheet 3 split: walls alone, spread out; lower brace, rail C and spacer rings to a new sheet 6
2026-10-26 Art: no space-filling or fractal curves (the Minkowski island read as a swastika); length-matched buses, tuned diff pairs, zig-zag antennas instead; re-cut sheet for the three art walls
2026-10-26 Pi wiring: three buttons on GPIO17/27/22 (pins 11/13/15, GND on 9), GPIO23/24/25 kept for three more; gpio-key overlay plan
2026-10-26 Rev 2.7: sleep button at the top wall's right end (top doubler notched, on the re-cut sheet); button roles and colours; screws, nuts, washers and buttons modelled in the shell; wiring doc §7 for four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
2026-10-26 Back cover screws: M3 x 10 ultra-low heads (5.5 x 1.0), 1 mm proud instead of 3; a PSU-style recess can't clamp the single-sheet cover at the rails
2026-10-26 Sheets: recut packed tight into one corner (379 x 247, leaves a ~227 x 305 offcut); sheet SVGs grouped score-then-cut with a group per part, every outline one closed path (same geometry, checked by r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
2026-10-27 Sheet SVGs: art merged into compound score paths, one per 50 mm patch of each part (sheet 2: ~36,000 objects -> 89, 3.9 -> 2.0 MB); same marks and order, checked by render diff
2026-10-27 Pi Zero USB Ethernet works: the OTG dongle was the fault; a plain micro-B-to-A OTG cable runs the RTL8153 at high speed and links the 5A-75B at 1000 Mb/s (renderer 10-15 fps, CPU-bound)
2026-10-27 Wiring doc: plasma confirmed on the panels from the Zero W
2026-10-27 Pi controller runs the demo suite (k0+k3 chord opens the switcher menu): /opt/patternflood/{demos,colorlight} as in the repo, settings in /etc/default/patternflood, upstream presets compiled on the P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
2026-10-27 Faster frames on the Zero W (about 5 -> 12 fps for SeungHun's presets, 4.8 -> 6.2 for Classic): runtime pipeline in float32 with a uint8 gamma table and a uint8 power cap, closed-form hsv(), colorsys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
2026-10-27 Pi 5 cards: provision_card.py tells armhf from arm64 by the image's rootfs and installs the matching pf-splash (new AArch64 syscall stubs, make pf-splash-arm64); [pi5] dtparam=uart0_console keeps the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
2026-10-28 Power docs: the 5 V bus in 22 AWG — 4 strands per pole from the LRS-50-5 (3 minimum, = 16/18 AWG), one pair per panel, Pi and Colorlight, crimped into a 1.5 mm² ferrule; drops worked out per 30 cm run
2026-10-28 Knob NeoPixels follow the panel brightness (k3) up to full scale: LIGHT_MAX 64 -> 255, scaled by bright on the panel's gamma curve (77 at the default 0.3, 255 at 1.0); docs give the 3V3 draw as up to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
2026-10-28 Community shelf takes the JavaScript-only patterns too (76 of 77): upstream's own Pattern Lab harness under node, sandboxed with no network, so the shelf holds 287 of the wall's 288
    sync fetches the harness's modules from upstream main and jsrun.mjs strips their types into
    one script the Pi's node 20 runs. One node child serves every JS pattern over pipes (knobs as
    on the community's cards: mid-range start, 48 detents end to end), holding the 8 most recently
    used. It runs under node's permission model in a network namespace of its own (unshare -rn on
    the Pi, bwrap on ash), tested to refuse writes, exec and TCP; a vm context was 80x slower. A
    frame over 1 s (5 s for a first frame) restarts no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
2026-10-28 Every community pattern reviewed for the 128 x 128 square: 225 take it as they are, 27 are enlarged by hand in community_ports/ (credited, CC BY-SA), 36 stay as published (games, fixed scenes, broken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
    community_review.json records the choice and why. check now keeps six frames over time and
    merges into checks.json under a lock, so ports can be checked side by side; strip shows a
    pattern's versions over time. The ports use the extra resolution rather than stretching: finer
    spirals, more strands and particles, bigger figures at their own aspect, whole tunnels and
    mandalas where the published frame cropped them. Both versions of all 288 checked (4 failur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
2026-10-28 Heavy community scripts run at their own frame rate: frames from node are pipelined, so the loop keeps 60 Hz while a pattern draws as fast as it can (Beating Blob at 128 x 128: ~15 fps on the Pi 5, 0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
2026-10-28 Solo Jazz, our first pattern for the community wall: the paper-cup swash improvised live (a teal dry brush on an attack/release envelope, a purple pen soloing in swung eighths to sixteenths), as a Pa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
2026-10-28 Solo Jazz is crayon on toothy paper: ink is rub pressure, showing only where it beats a fixed paper grain (streaky along the strokes), so fresh swashes are dense but flecked, the brush scribbles in d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
2026-10-28 Solo Jazz is played by a quartet on paper two screens each way: the soloist always in view, three more anywhere (laying out a little more), each landing where the paper is emptiest, so zooming out (n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
2026-10-28 Solo Jazz in its own time no longer bumps to a beat: the purple's warp crawls smoothly along the strokes (read between rows, so it glides rather than stepping a pixel at a time), no zoom pump, k0's l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
2026-10-28 The chassis power switch is safe: libraries are fsynced before they're named (a power cut after a compile left one named but empty, which took the renderer down), an empty preset library is rebuilt, 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
2026-10-28 Boot to the first frame on the panels in 7.9 s from the kernel, not 16.2: the renderer no longer waits for network.target, cloud-init switches itself off after the first boot (update_pi.py does it on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
2026-10-28 Interdimensional Cable, a shelf of its own: Cable surfs 25 short, very weird channels from other dimensions (infomercials, news, game shows, a soap, a nature doc, and silent physical comedy: a PULL d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
2026-10-28 Cable's headlines cache in the service's own CacheDirectory (/var/cache/patternflood, $CACHE_DIRECTORY) on the Pi, whose renderer has no home to write to; a cache that can't be written no longer read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
2026-10-28 Cable plays each clip two to four times over (about 24 s), then surfs on to a channel at random, every one once before any repeats; the networks' grey bugs are gone from the corner; and the headline 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
2026-10-28 Tapes from public-domain trims: tools/cable_trims.py fetches eight public-domain sources from the Internet Archive once (their small copies, one at a time, at most 1.5 MB/s, our own user-agent, MD5-c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
2026-10-28 Cable grows to 103 drawn channels in five themed batches (lineup.py): 16 commercials (101-191), 15 TV formats gone wrong (201-287), 16 silent slapstick (301-396), 16 kids' TV, docs and PSAs (501-597)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
2026-10-28 Cable's channels come in a shuffled order, new each time it starts and after every lap: the knobs step forward and back through it (back returns to what you were just watching) and the surf walks it,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
2026-10-28 Sheet SVGs: open art traces back to one polyline each, as XCS closes every subpath of a compound path (it folded each trace back to its start and filled the folds as blobs); only rings and closed tra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
    Rendered against the pre-merge files the traces are identical; the rings differ by their 0.01 mm rounding only.
2026-10-30 Ready for the public: a build guide for the desktop (docs/desktop/BUILD.md: parts, flashing the card, the Pi image, test cuts, cutting, glue-up, mains and wiring, first power-up, known gaps) for Rev 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
2026-10-30 Vendor CAD: the Waveshare P2.5 model is no longer kept here (its licence is unclear); its measurements stay, with a link to where it lives
2026-10-30 Photos of the build: test cuts, cutting, Rev 1's frame, back and card on JTAG, Rev 2's walls, the Pi's header, Rev 2.7 from the front, top, back and inlet, and the boot splash; in BUILD.md at each st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
2026-10-30 Test cuts and sheets for a fresh build: the second test sheet is part 2 (test-cuts/part-2/, test_cuts_part2.py), not 'since rev 1'; the re-cut sheet is gone (the six sheets already carry the current 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
2026-10-30 Design notes are history, not reference: the main docs no longer cite them for current facts (the panel's measurements are in enclosure-lasercut.md §11, the 5 V bus in wiring.md), the desktop index l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
2026-10-30 driver-colorlight.md: drop the panel-chip section (the chips are in BUILD.md's parts list); later sections renumbered, references follow
2026-10-30 driver-colorlight.md: the vents are done (bottom-wall intake, side-wall exhaust, plain back cover), not an open item
2026-10-30 BUILD.md: the Pi header photo's wire colours aren't the STEMMA QT code; wire by the table
2026-10-30 Buttons: say Dupont wire connectors (female, 2.54 mm, 4-pin and 2-pin), not housings
2026-10-30 README: the back cover's title block and credits plate as a banner, a clip of the knobs at work beside the front, and five demo loops rendered from the renderer (Solo Jazz, Obra, Riso, Valley, Sea; 2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
2026-10-30 Block wiring diagram (docs/desktop/img/wiring-blocks.svg) in the README, wiring.md and BUILD.md §8; the 5 V side as built: three Waveshare panel harnesses stacked on the supply's screws, six 4-pin pl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
2026-10-30 Buttons in the renderer, on a common ground: previous and next step along the shelf (held, they repeat), select opens and closes the menu (where previous and next change shelf), sleep blanks the pane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
2026-10-30 Cable: previous and next change channel (demos can take them with skip(d)); quick to start, as the menu passes through it: each channel is made when first tuned, and the tapes are probed in the backg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
2026-10-30 Build guide: seven more photos of Rev 2.7 going together. The buttons from inside before wiring (7.3); in section 9 the tray on the bench, the tray in with its ribbons, crimping and wiring the button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
2026-10-30 Community: Starlight Jester Ribbon ported to 128 x 128. Grown as written, its ribbon was cut off below row 100: at 128 wide the ribbon covers 5403 pixels, and the baked pixel list, filled top down, h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
2026-10-30 Community: Hop Hop Up at 128 x 128. It was kept as published only for being a game, but its world is drawn in proportion to the frame, and at 128 wide the sky doubles across the square with the chick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
2026-10-30 5 V side as built: a bus of two 4-way barrier strips (+5 V and GND), fed by one 16 AWG pair from the supply, with the three panel harnesses' forks on the strips; stacking three fork pairs on the supp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
2026-10-30 Docs link the public Onshape document: the README, the build guide (intro and the re-export step), the desktop README, onshape-workflow.md (top and §8), enclosure-lasercut.md and REVISIONS.md all poi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
2026-10-31 Build guide §1 is a bill of materials: each part gains a source and a US price checked 2026-10-30, and a cost summary comes to about $565 before shipping. The Pi 5 is the 2 GB (the box uses ~350 MB o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
2026-10-31 Bill of materials prices what one box uses: a pack's price is the box's share of it, with the pack price kept in the Source column. About $400 a box (electronics 325, power 25, enclosure 40, fastener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
2026-10-31 Shelves reorganized, in menu order: Patternflow (SeungHun's 48 alone, at 128 x 128), Community 1:1 (the wall as published, mechanical fixups only), Community (each at its best), Patternflood (ours: t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
2026-10-31 Review the 7 patterns new on the wall 2026-10-30: HYPERSPACE RIBBONS, Hi how are you?, Quousque Tandem, Haunted Clearing and Candle light at 128 x 128 (the last three unseen); Train (a fixed framed s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
2026-10-31 The box starts where it was left, after a restart, an update or a power cut: the demo, each shelf's place, the brightness, the audio-knobs switch and each demo's knobs, in /var/lib/patternflood/sessi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
2026-11-01 Moon: eight worlds and two ways to watch. New: Mars (ice caps, Olympus Mons and the Tharsis volcanoes, Valles Marineris, dusty air), Europa (cracked ice), a molten world (glowing seams between crust 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
2026-11-01 Moon: the Earth in colour, a blue marble. NASA's public-domain maps (Blue Marble Next Generation, topography and bathymetry, July 2004, by day; Black Marble 2016's city lights by night) at 512 x 256 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
2026-11-01 Desktop docs: ideas for Rev 3 and later (a mic jack and stand for a Participation TV, audio out with a speaker, a camera with a shutter, a light sensor, haptics behind the knobs, a web UI, OSC, a spo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
2026-11-01 A web remote: http://patternflood.local/ is the box in a browser. The panel live at 30 frames a second, each LED drawn round as on the P2s, with its glow on the birch; the four knobs, lit as the patt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
    pfd/web.py is a standard-library HTTP server on threads of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
